aryanjaykadu/F1-sma-brake-duct/bench/Phase4_Bench_Dashboard.png

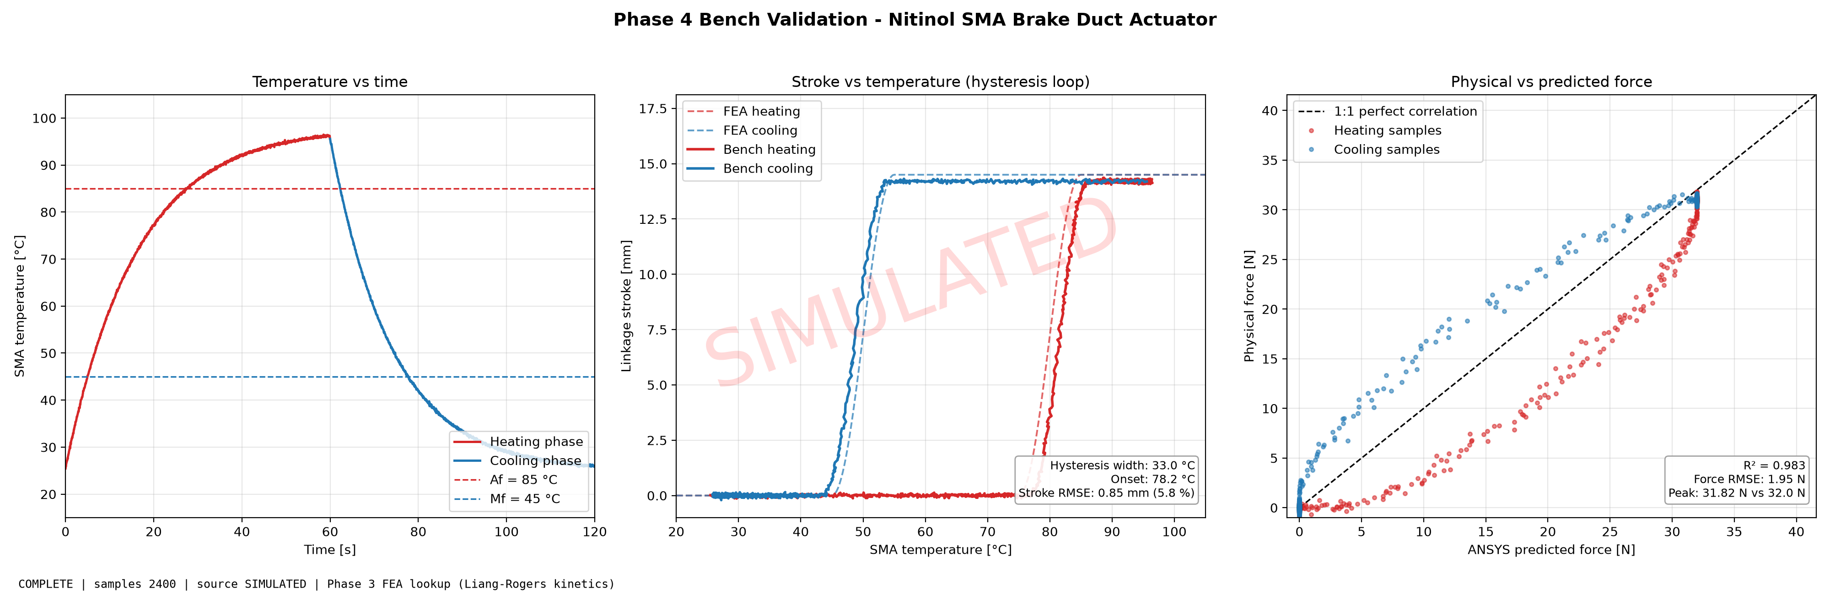
bench/Phase4_Bench_Dashboard.png
