aryanjaykadu/F1-sma-brake-duct/bench/virtual/Logger_Twin_Dashboard.png

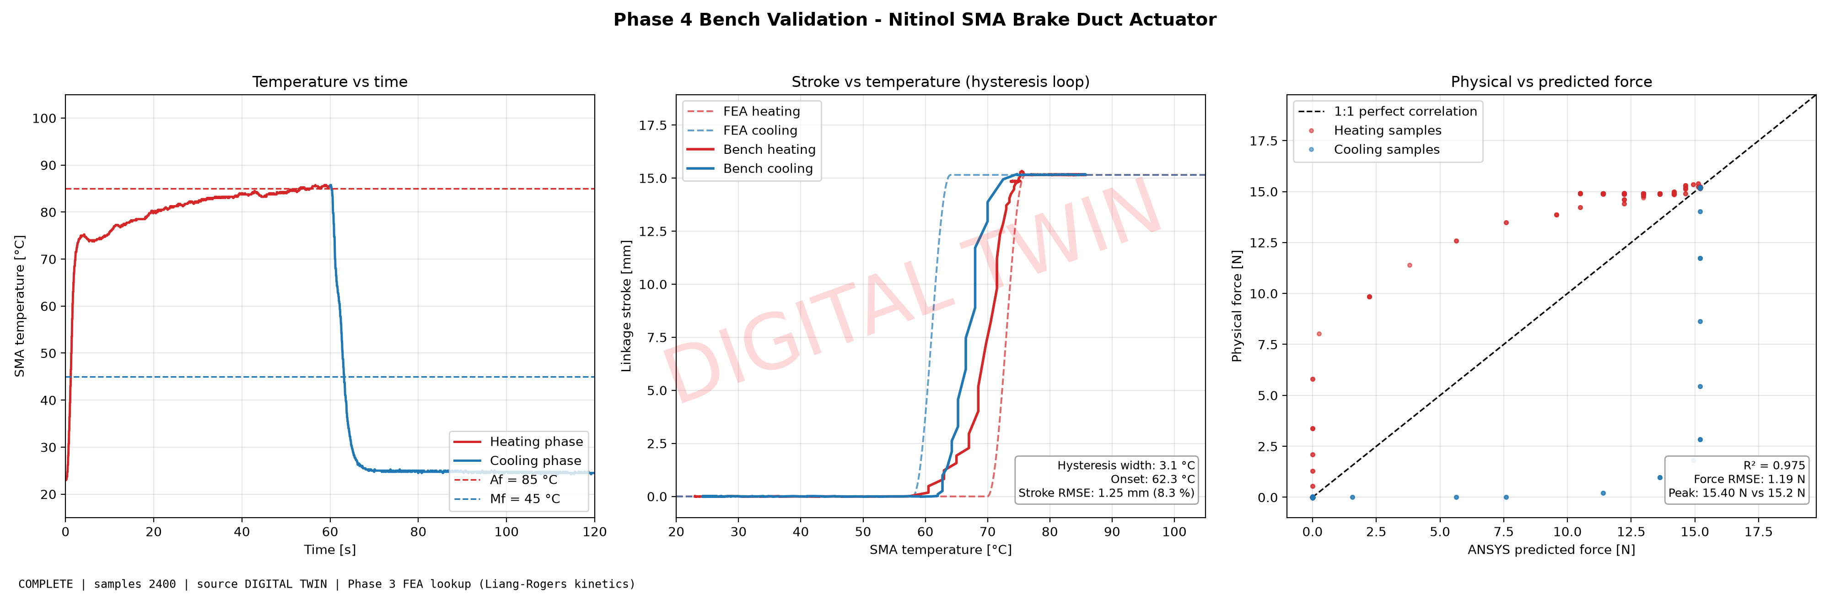
bench/virtual/Logger_Twin_Dashboard.png
