aryanjaykadu/F1-sma-brake-duct/bench/virtual/T4_endurance.png

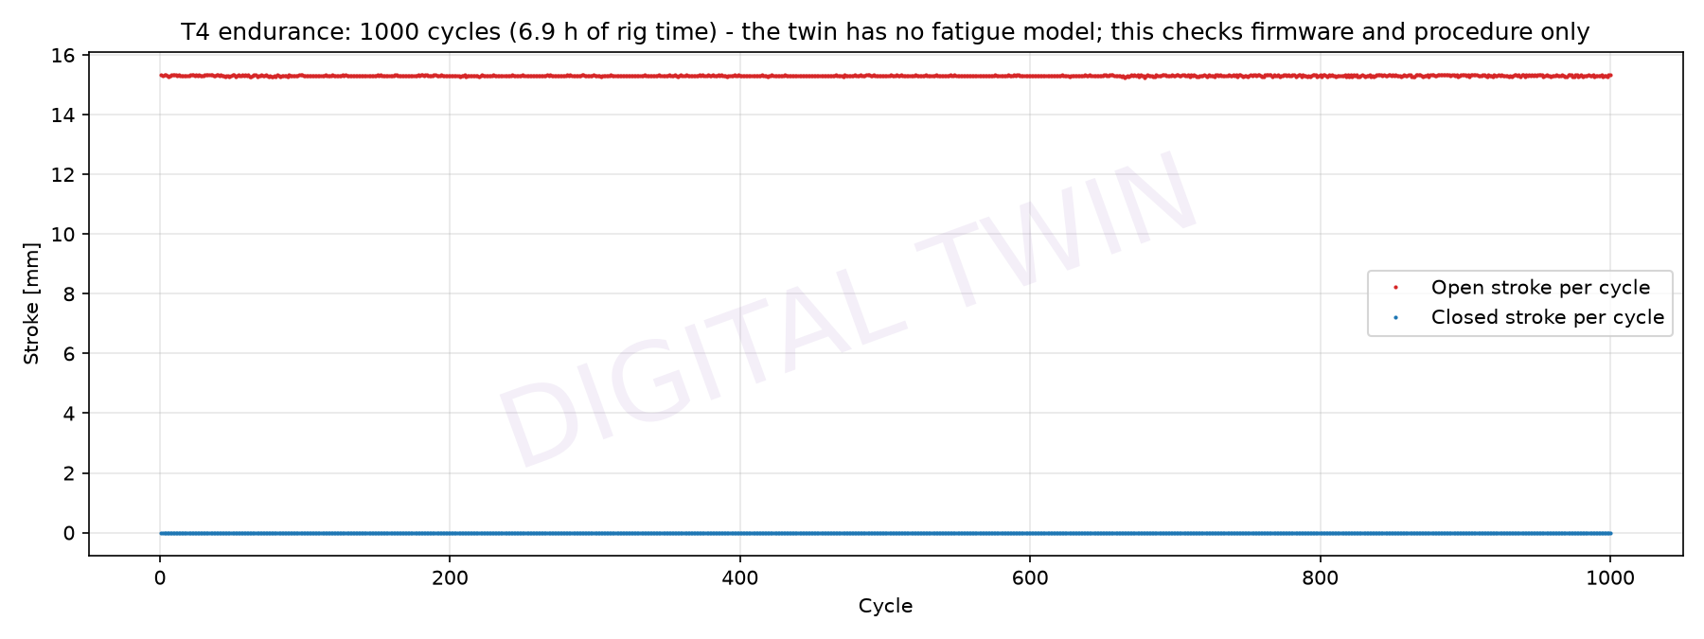
bench/virtual/T4_endurance.png
