aryanjaykadu/F1-sma-brake-duct/cad/Brake_Duct_Housing.png

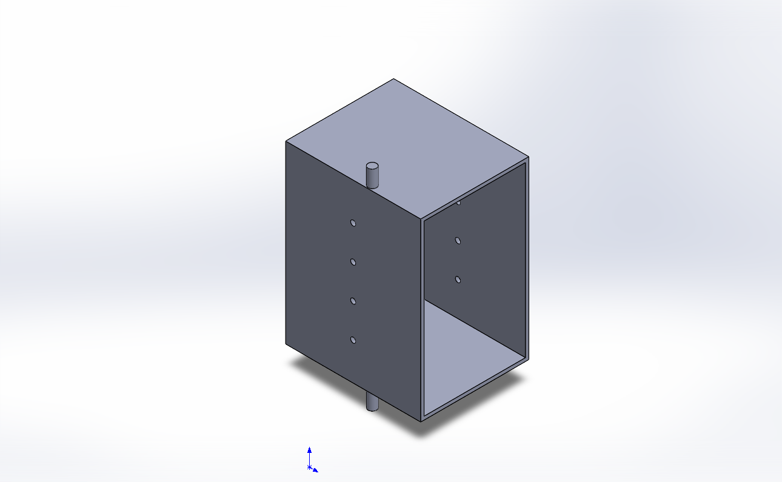
cad/Brake_Duct_Housing.png
