aryanjaykadu/F1-sma-brake-duct/cad/Control_Linkage_Rod.png

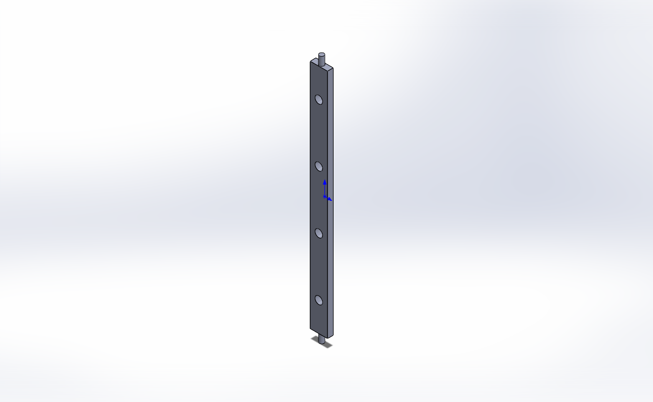
cad/Control_Linkage_Rod.png
