aryanjaykadu/F1-sma-brake-duct/cad/Nitinol_Louver_Flap.png

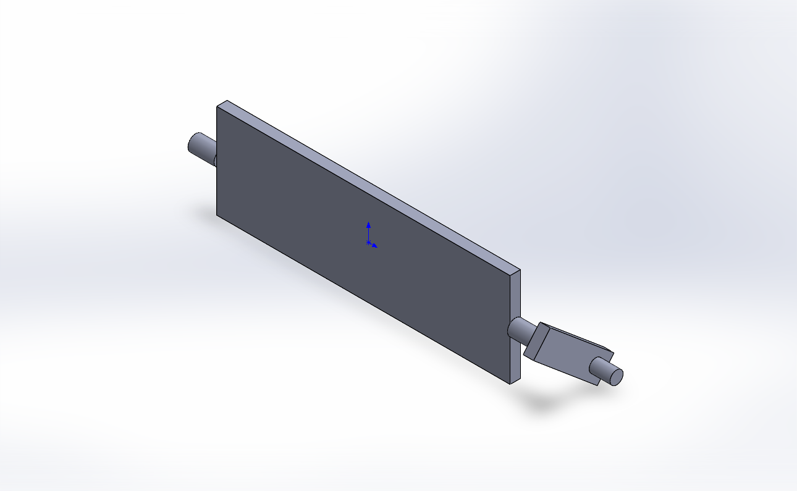
cad/Nitinol_Louver_Flap.png
