aryanjaykadu/F1-sma-brake-duct/cad/product/Module_right.png

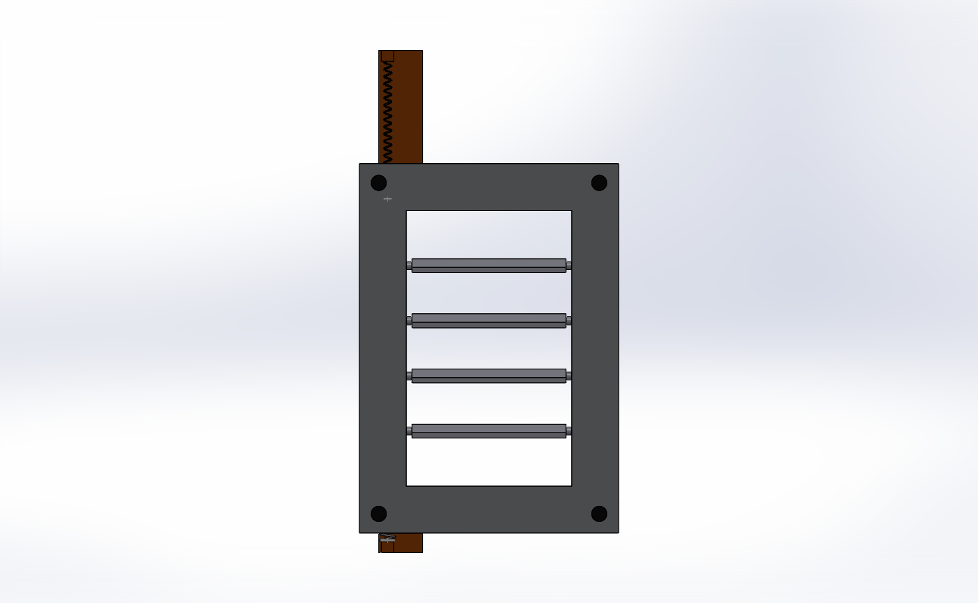
cad/product/Module_right.png
