aryanjaykadu/F1-sma-brake-duct/cad/rig/Bench_Rig_front.png

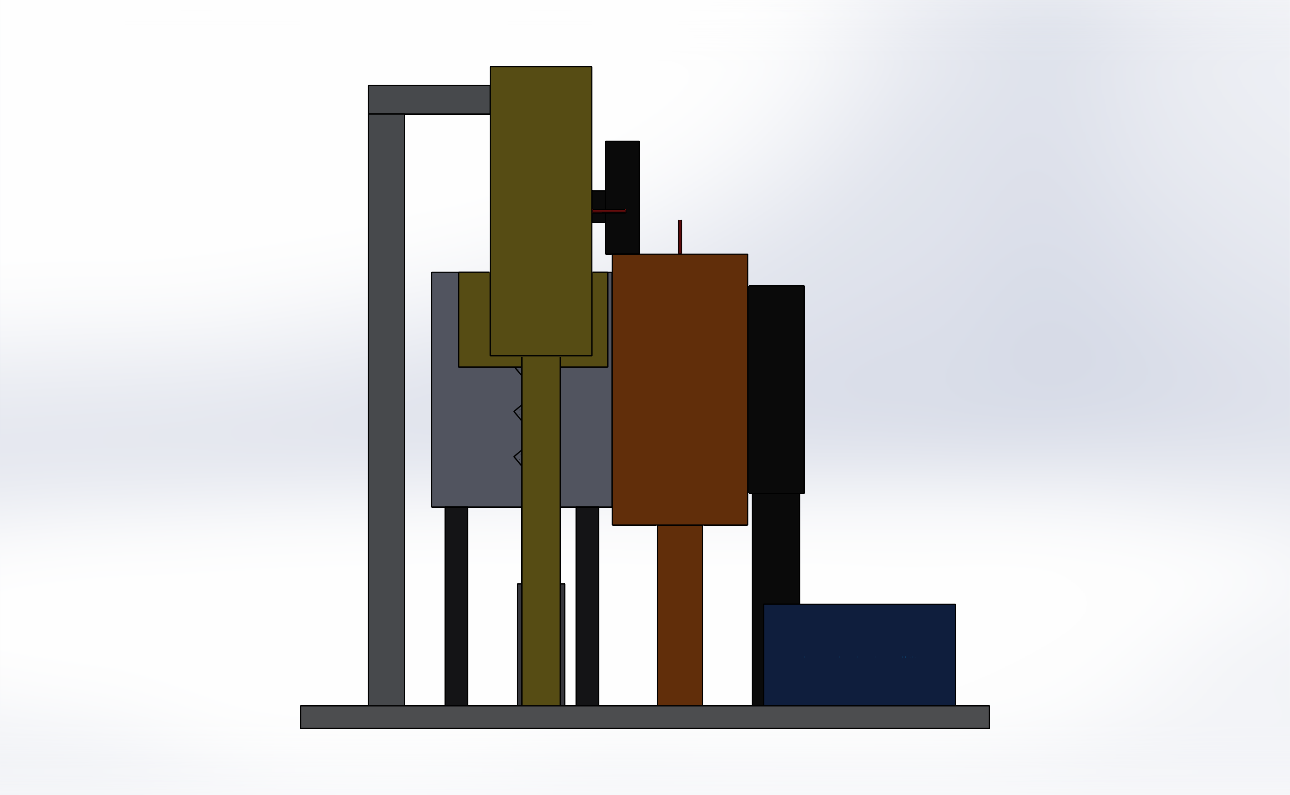
cad/rig/Bench_Rig_front.png
