aryanjaykadu/F1-sma-brake-duct/cad/rig/Bench_Rig_top.png

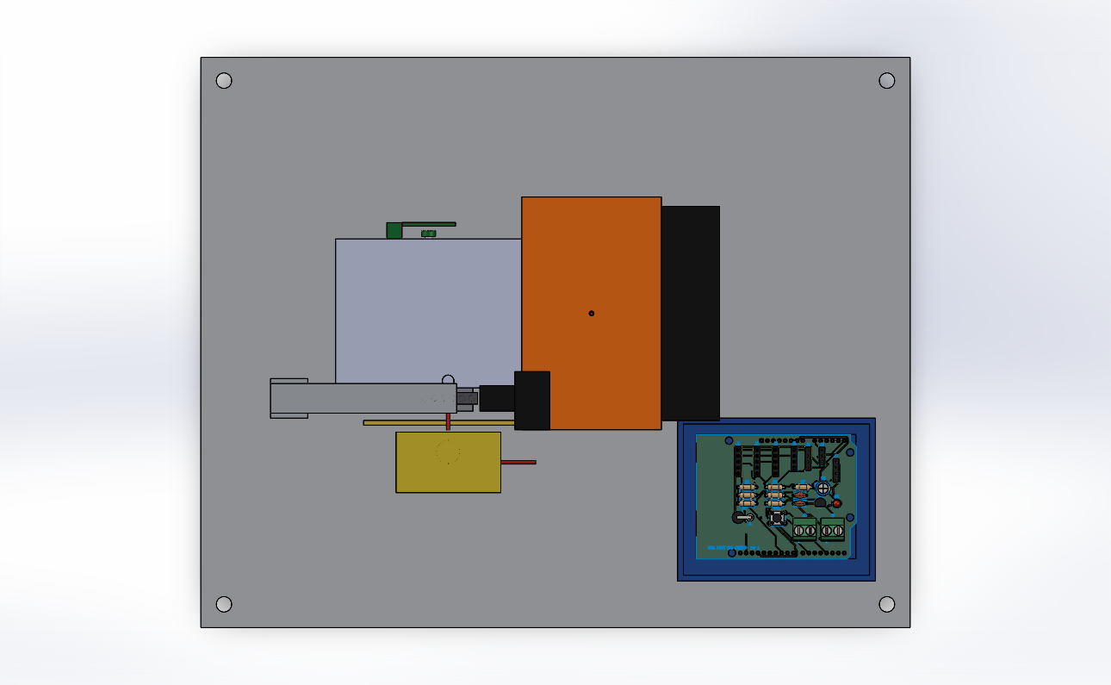
cad/rig/Bench_Rig_top.png
