aryanjaykadu/F1-sma-brake-duct/cad/rig/Sensor_Shield_PCB.png

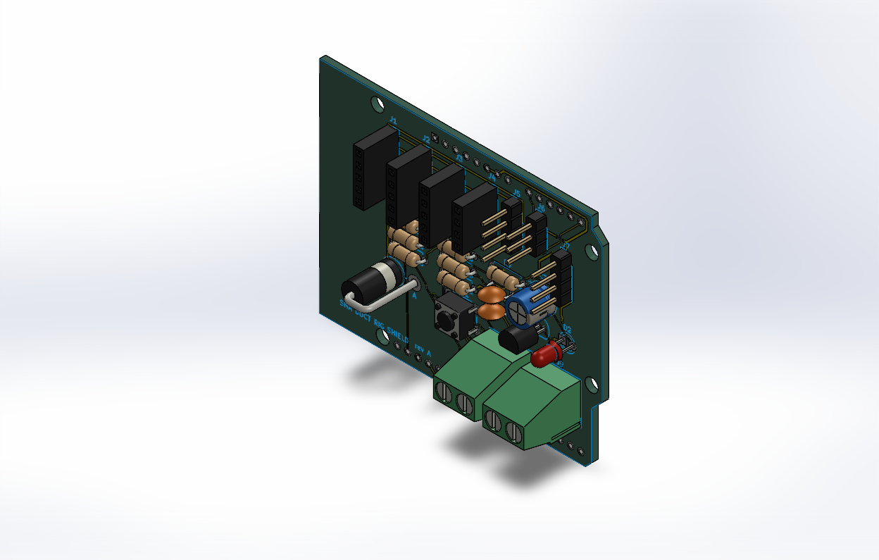
cad/rig/Sensor_Shield_PCB.png
