aryanjaykadu/F1-sma-brake-duct/cfd/Phase2_CHT_Domain.png

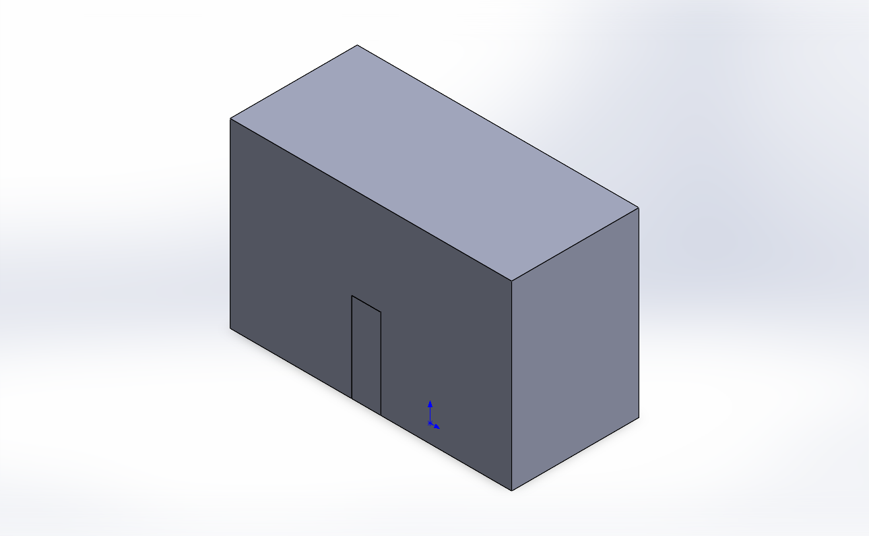
cfd/Phase2_CHT_Domain.png
