aryanjaykadu/F1-sma-brake-duct/cfd/SMA_Wire_Temperature_CaseB.png

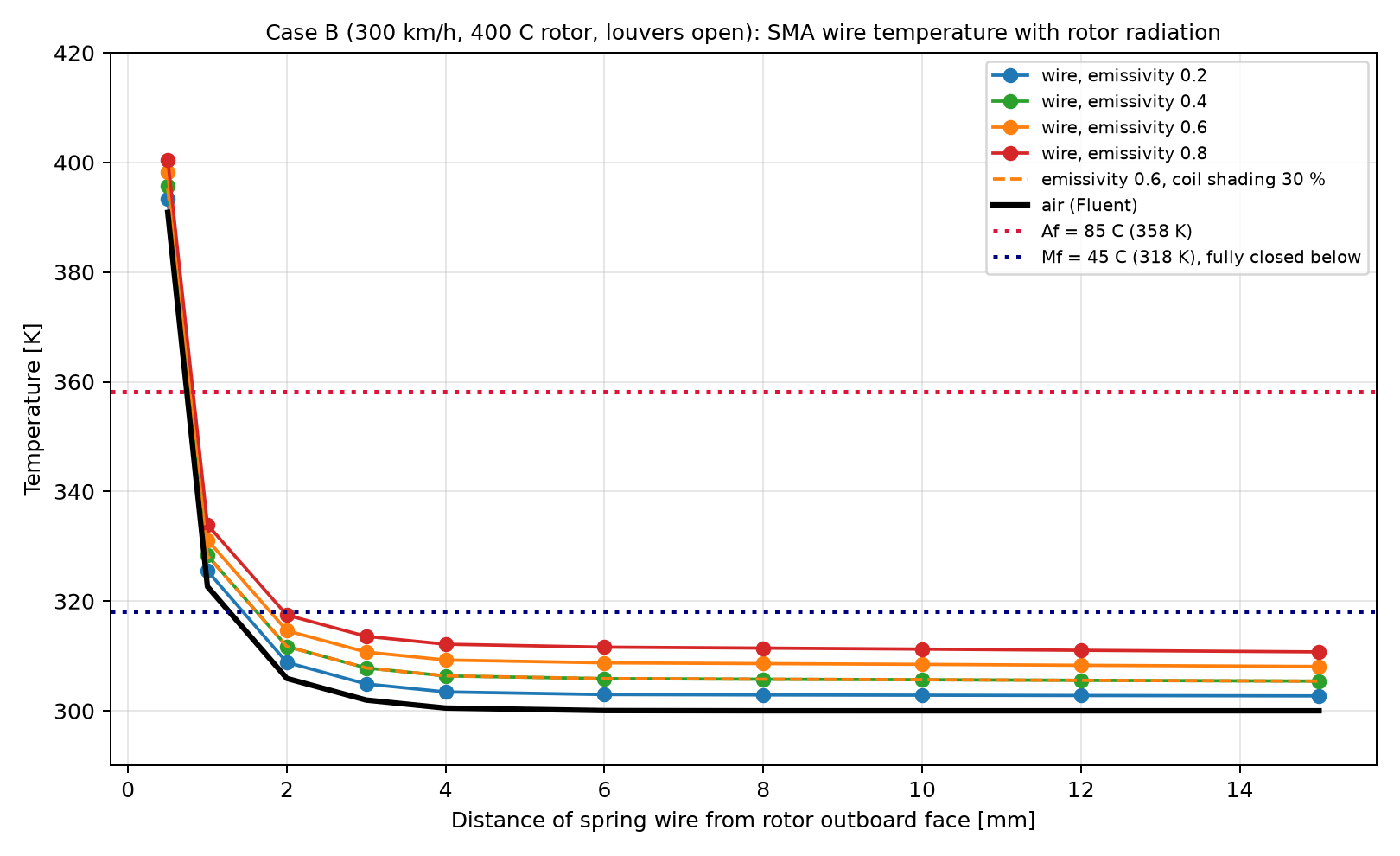
cfd/SMA_Wire_Temperature_CaseB.png
