aryanjaykadu/F1-sma-brake-duct/cfd/Temp_Contour_CaseA_baseline.png

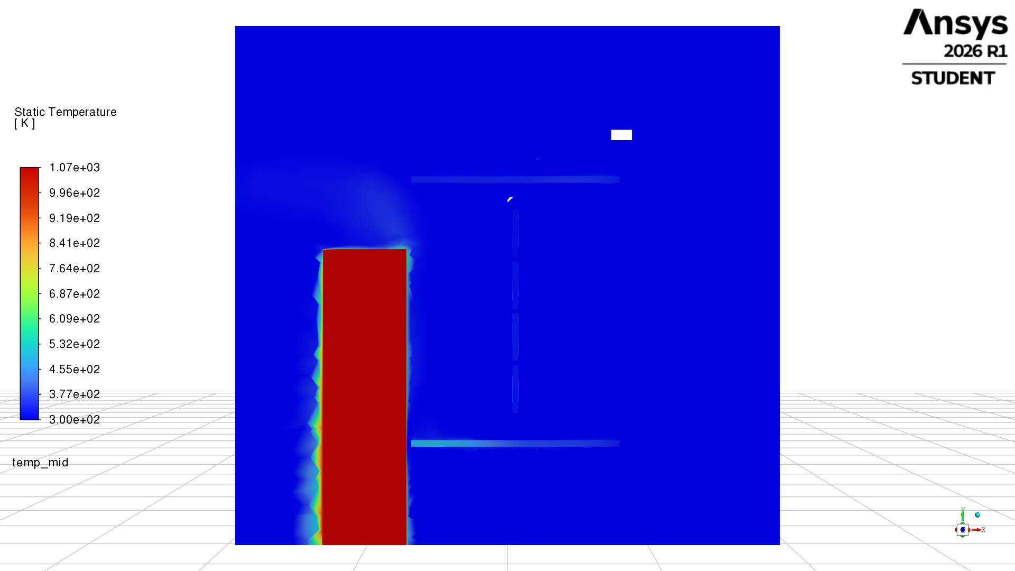
cfd/Temp_Contour_CaseA_baseline.png
