aryanjaykadu/F1-sma-brake-duct/cfd/transient/Transient_Lap_NiTi_Af85_gap6_eps0.6_d1.2.png

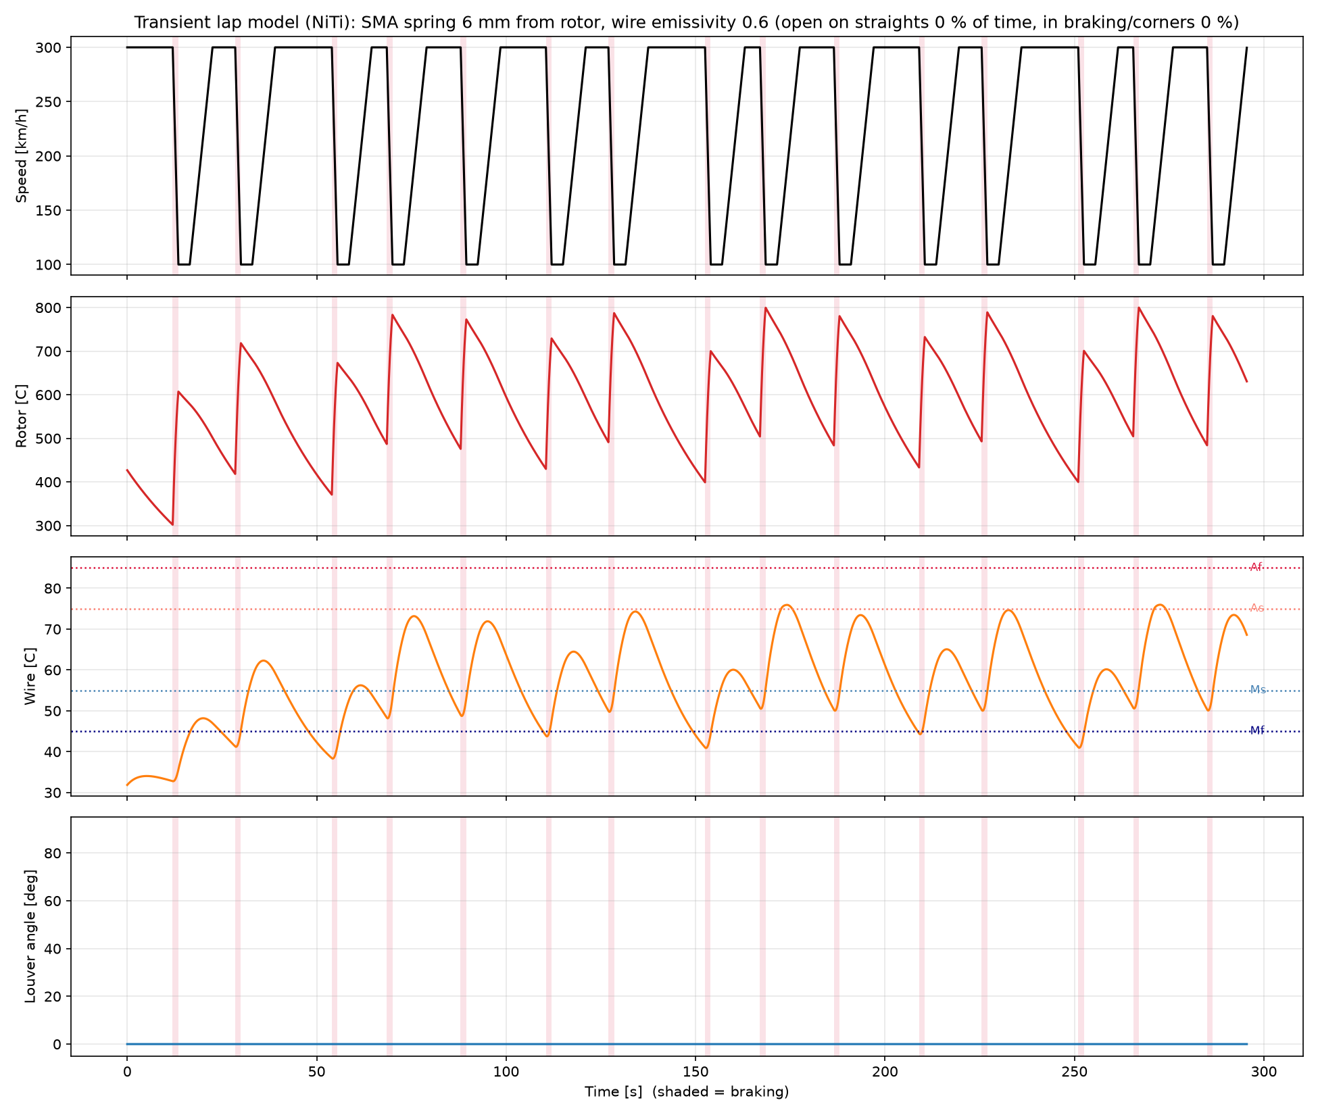
cfd/transient/Transient_Lap_NiTi_Af85_gap6_eps0.6_d1.2.png
