aryanjaykadu/F1-sma-brake-duct/cfd/Velocity_Contour_CaseA_baseline.png

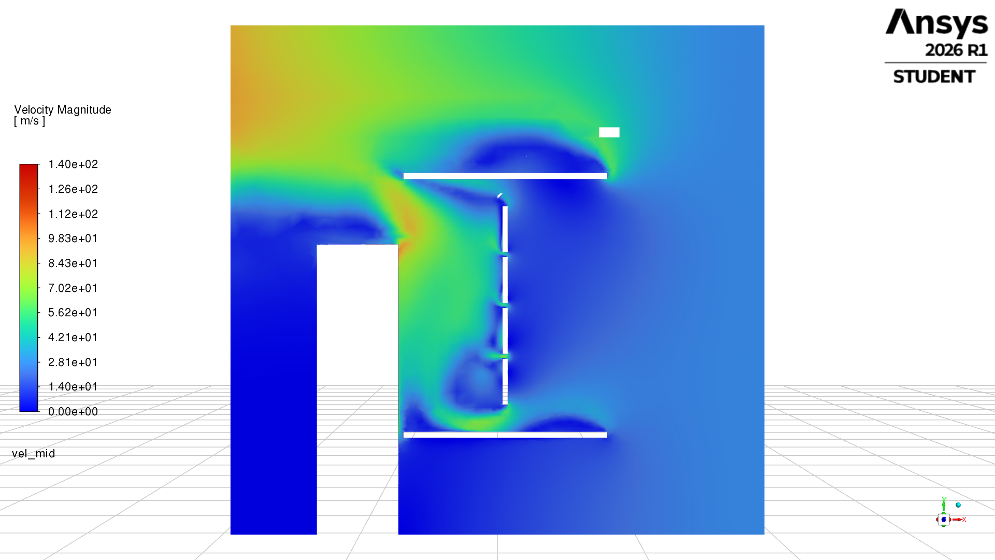
cfd/Velocity_Contour_CaseA_baseline.png
