aryanjaykadu/F1-sma-brake-duct/cfd/wheel/Wheel_Aero_Closed.png

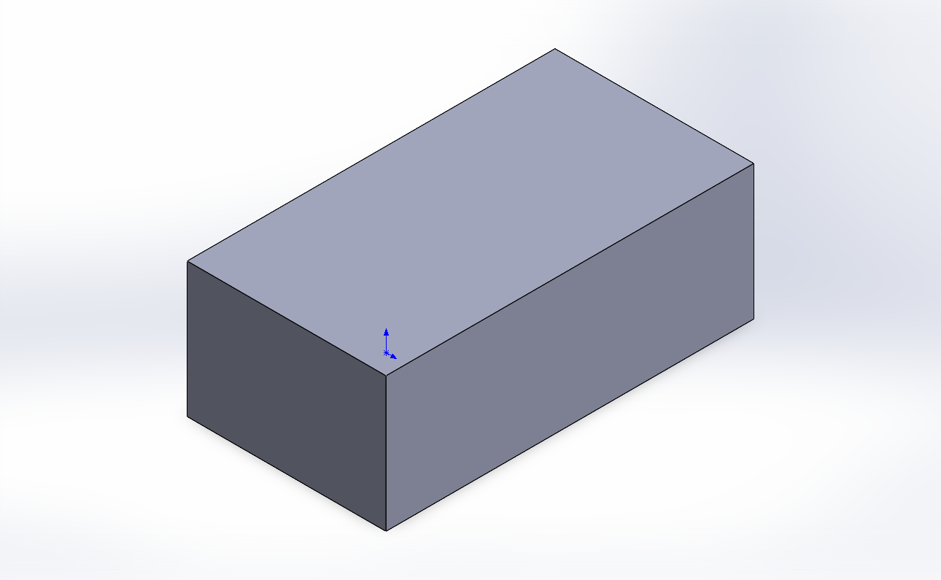
cfd/wheel/Wheel_Aero_Closed.png
