aryanjaykadu/F1-sma-brake-duct/electronics/kicad/render_bottom.png

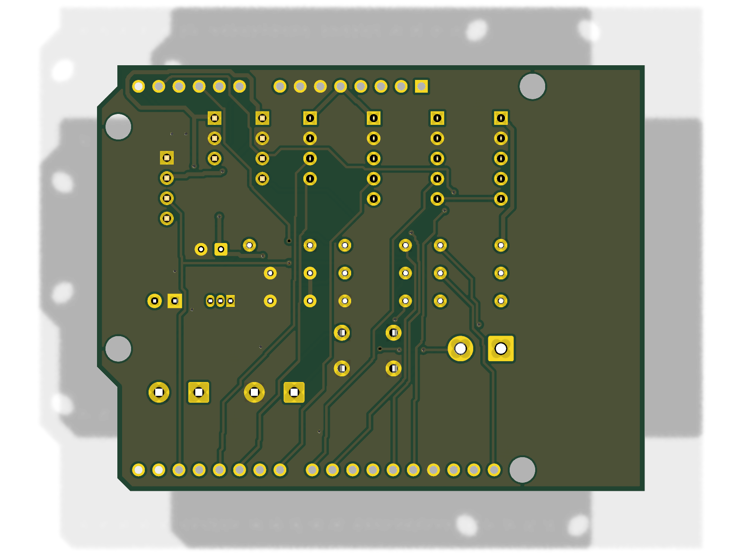
electronics/kicad/render_bottom.png
