aryanjaykadu/F1-sma-brake-duct/ev/cad/EV_Shutter_Closed_iso.png

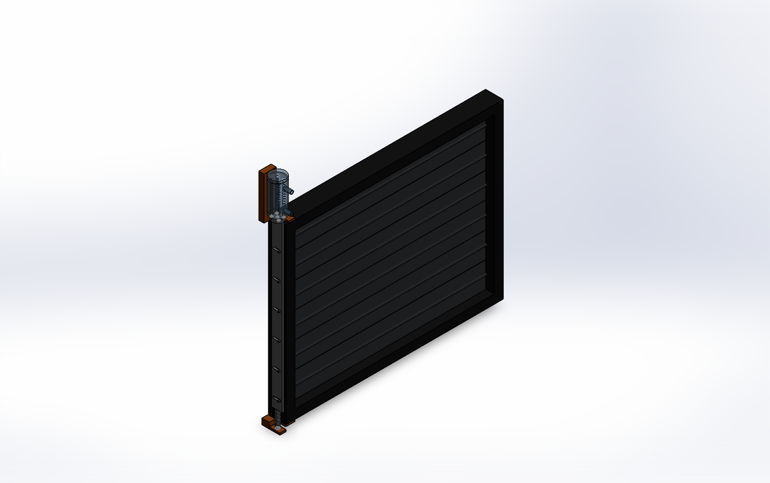
ev/cad/EV_Shutter_Closed_iso.png
