aryanjaykadu/F1-sma-brake-duct/ev/cad/EV_Shutter_Open_right.png

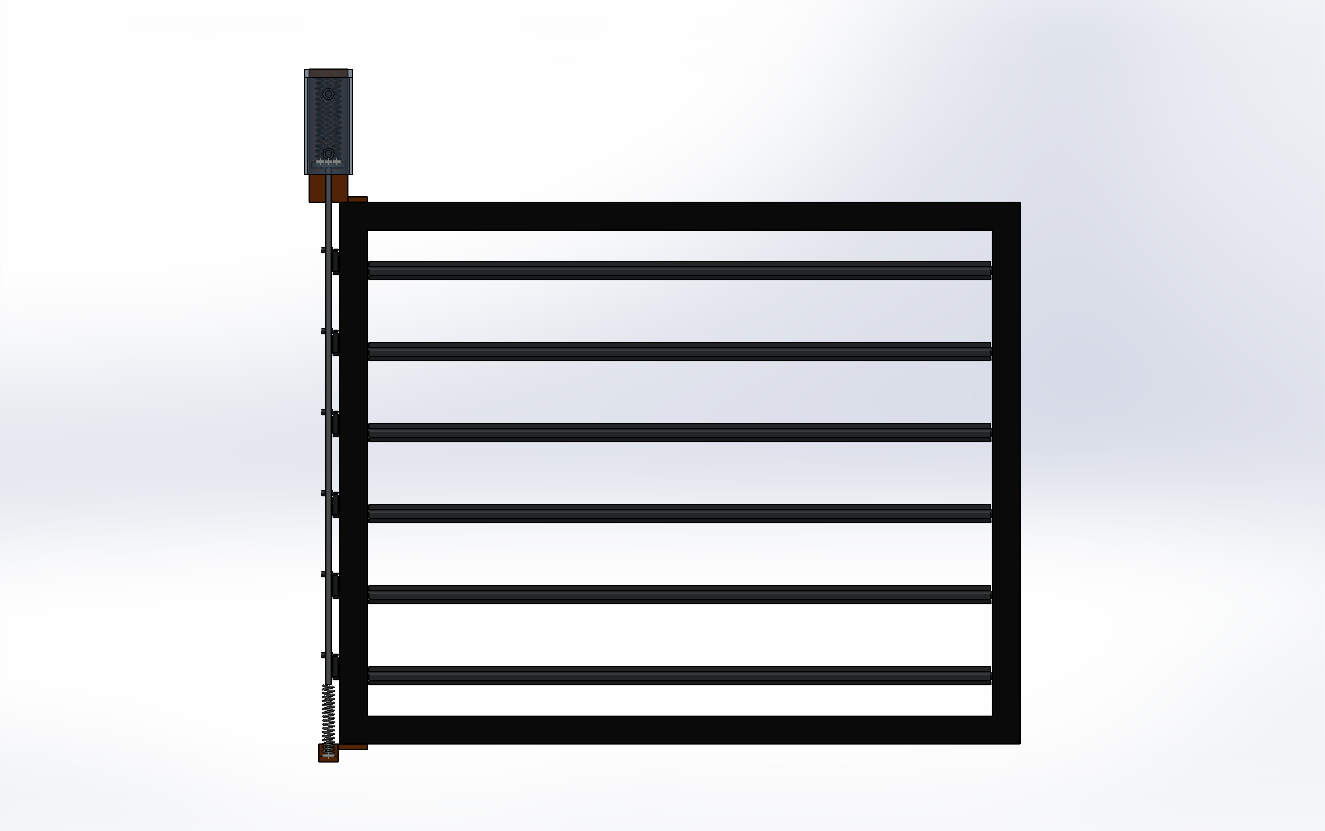
ev/cad/EV_Shutter_Open_right.png
