aryanjaykadu/F1-sma-brake-duct/ev/cfd/EV_Front_Closed.png

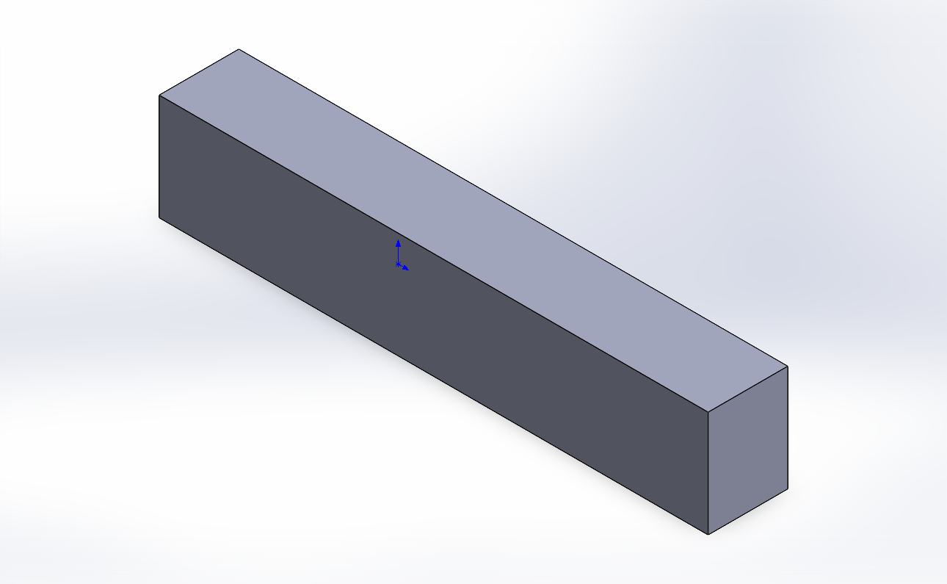
ev/cfd/EV_Front_Closed.png
