aryanjaykadu/F1-sma-brake-duct/ev/EV_System_city_wltc_x2_25C.png

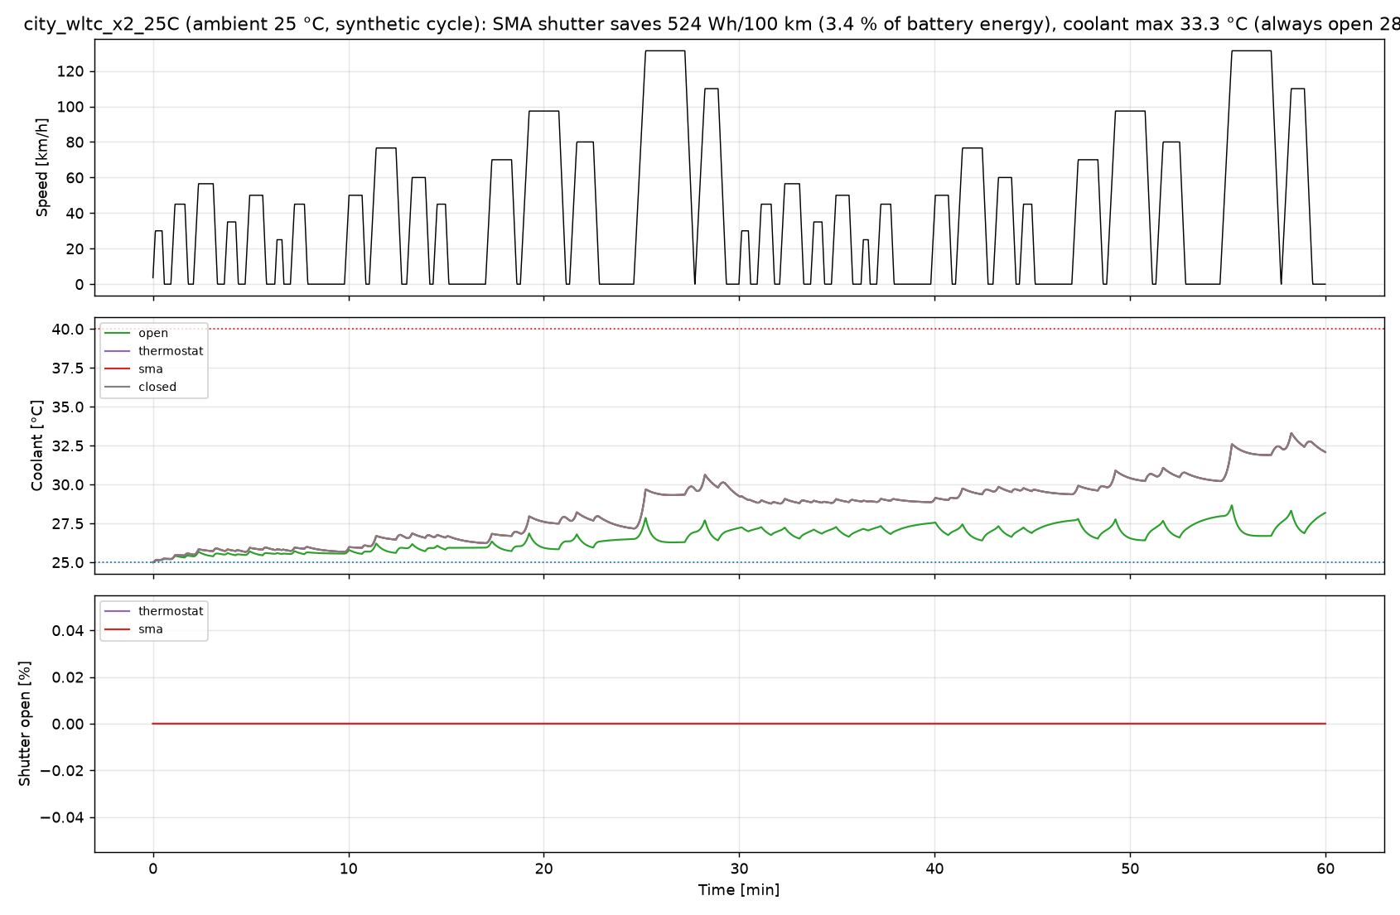
ev/EV_System_city_wltc_x2_25C.png
