aryanjaykadu/F1-sma-brake-duct/ev/EV_System_hot_day_motorway_38C.png

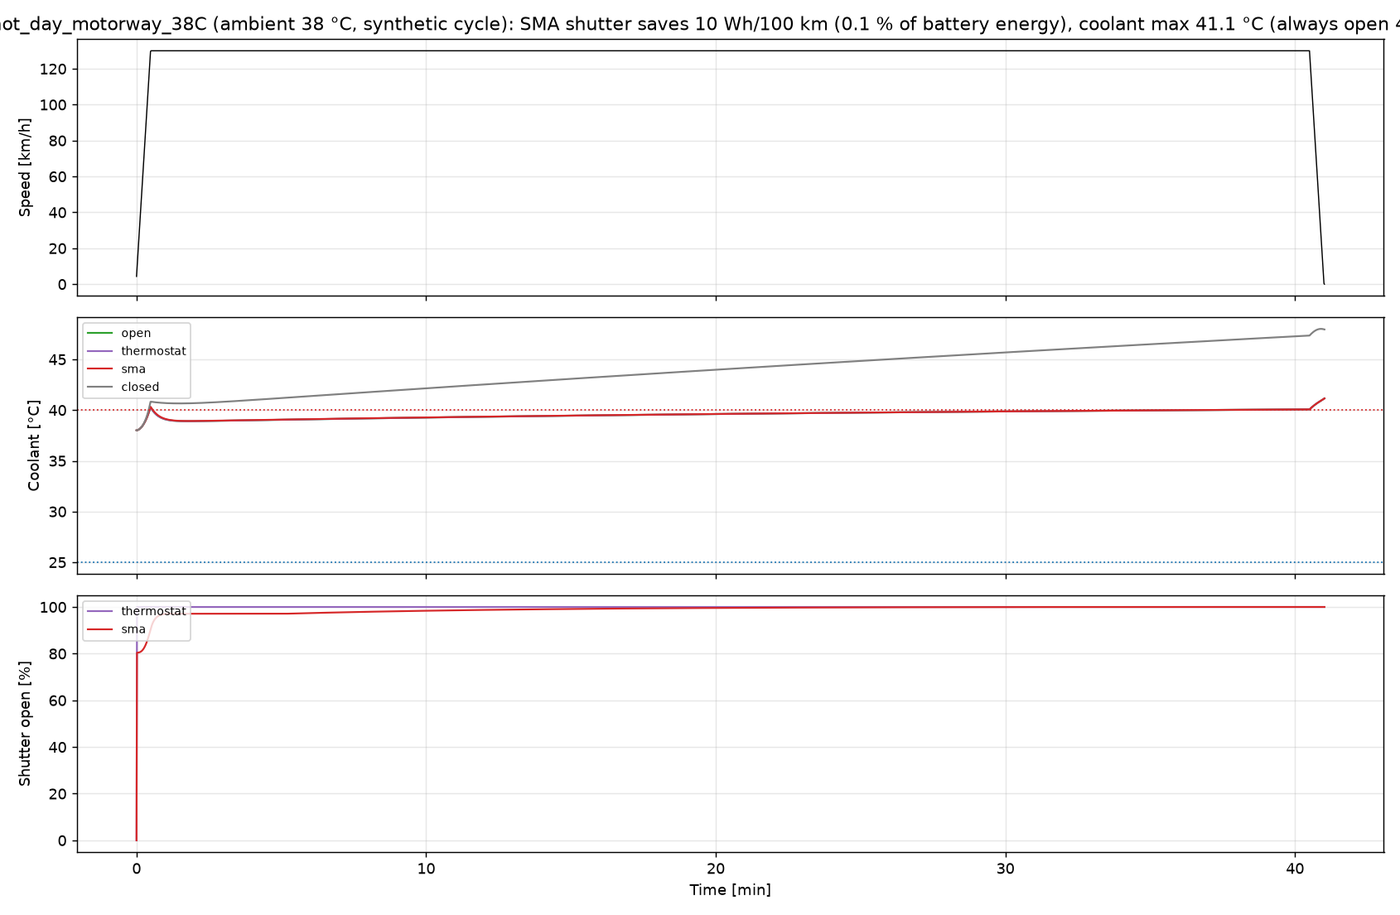
ev/EV_System_hot_day_motorway_38C.png
