aryanjaykadu/F1-sma-brake-duct/ev/EV_System_hot_day_motorway_38C_kappa_cfd.png

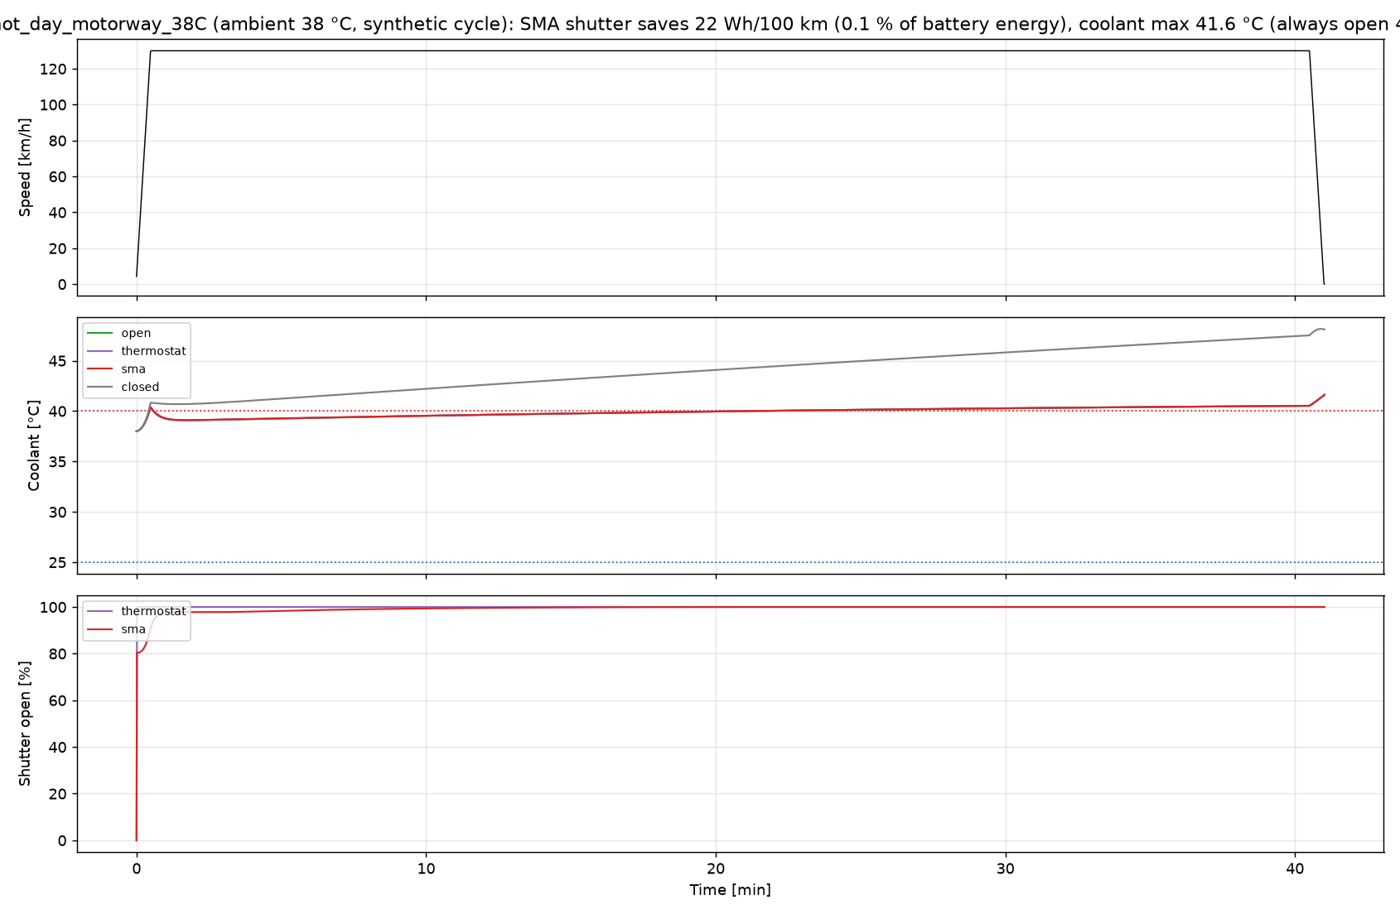
ev/EV_System_hot_day_motorway_38C_kappa_cfd.png
