aryanjaykadu/F1-sma-brake-duct/ev/EV_System_motorway_130_30C_kappa_cfd.png

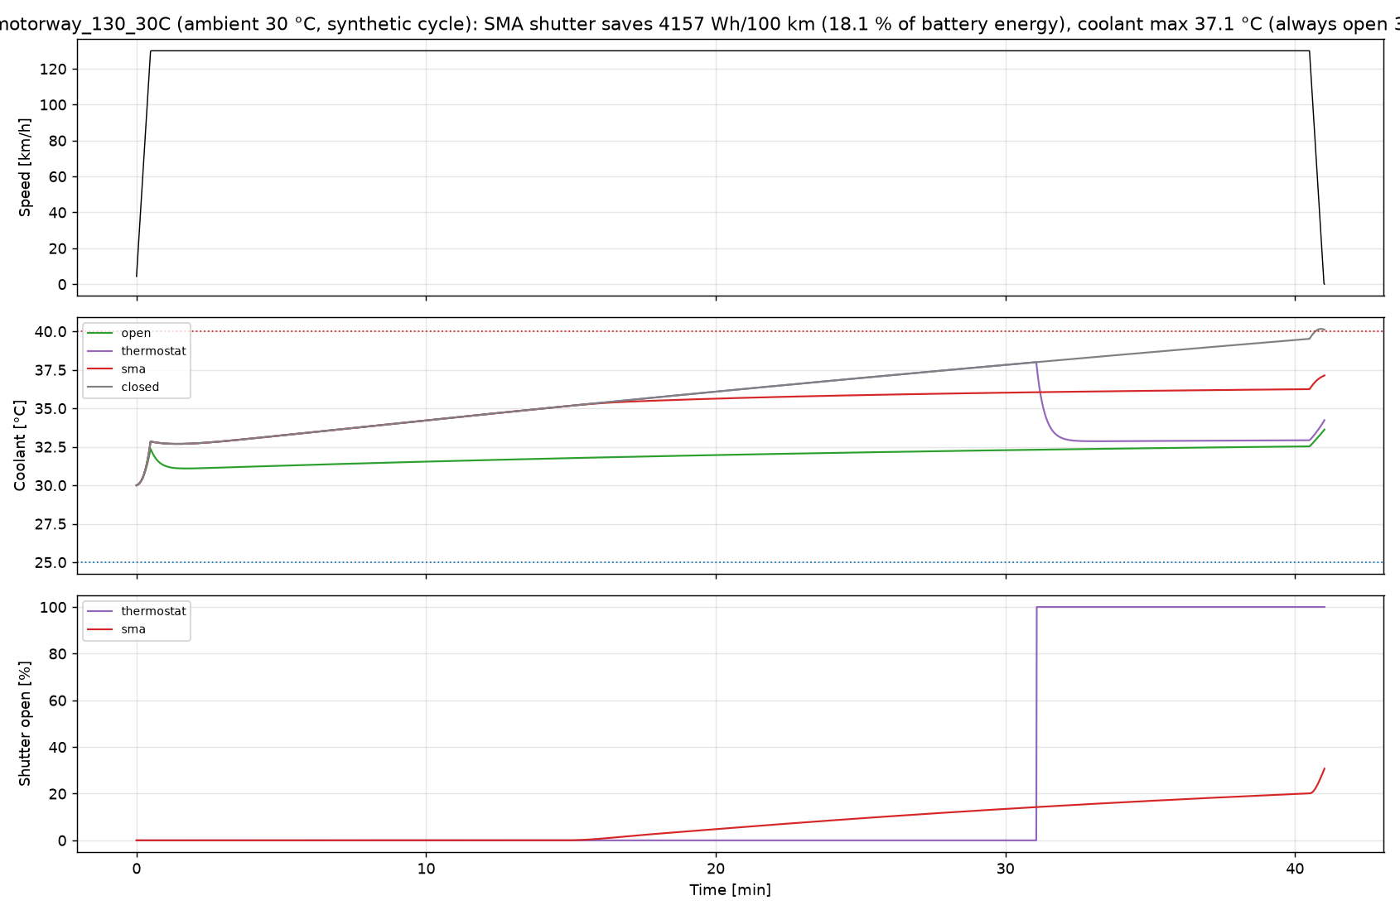
ev/EV_System_motorway_130_30C_kappa_cfd.png
