aryanjaykadu/F1-sma-brake-duct/fea/FEA_Deformation_Map.png

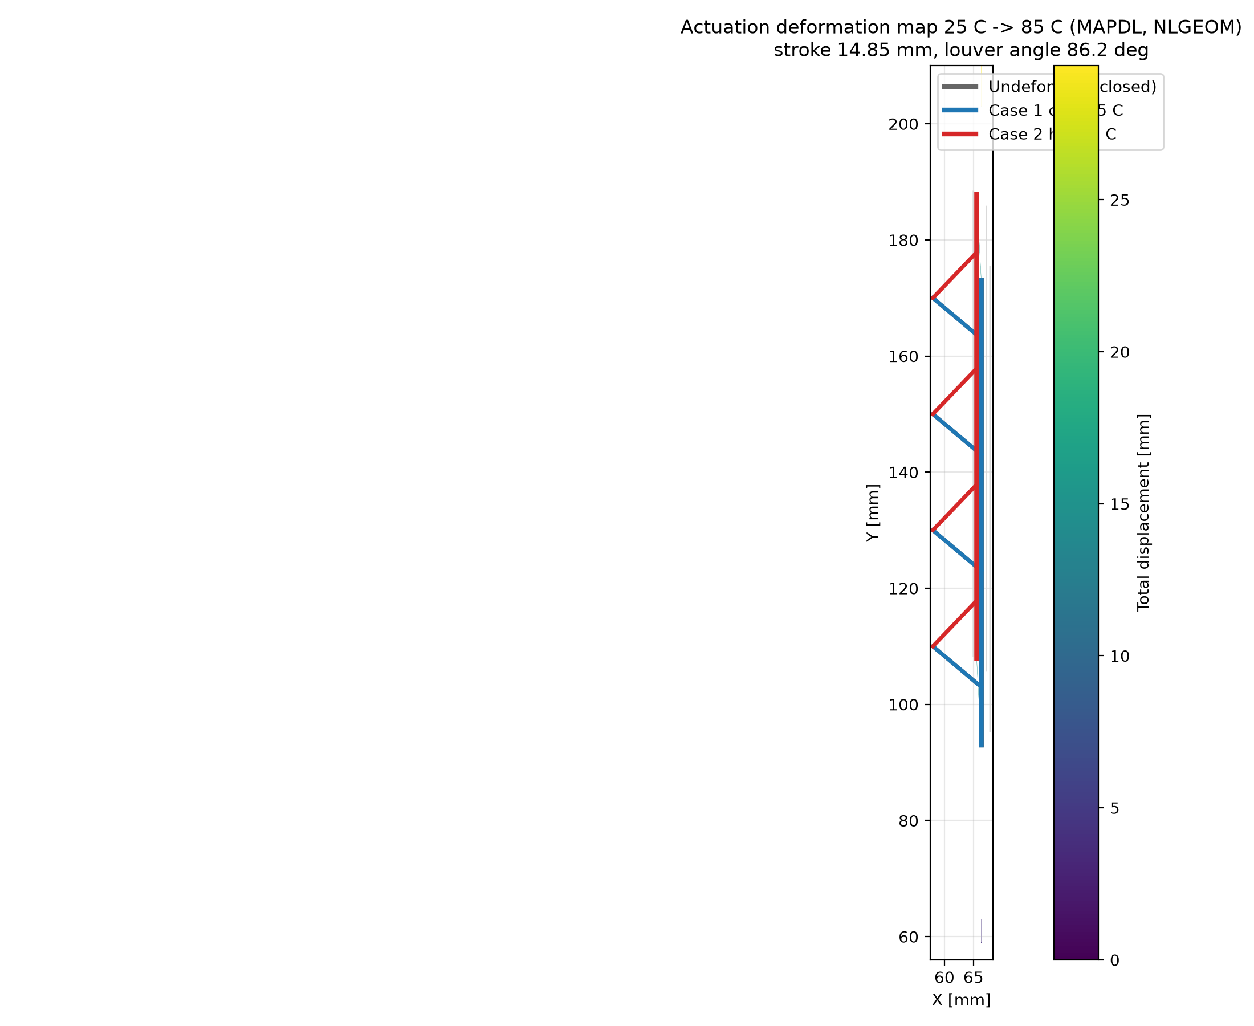
fea/FEA_Deformation_Map.png
