aryanjaykadu/F1-sma-brake-duct/fea/FEA_Stress_Contour_Hot.png

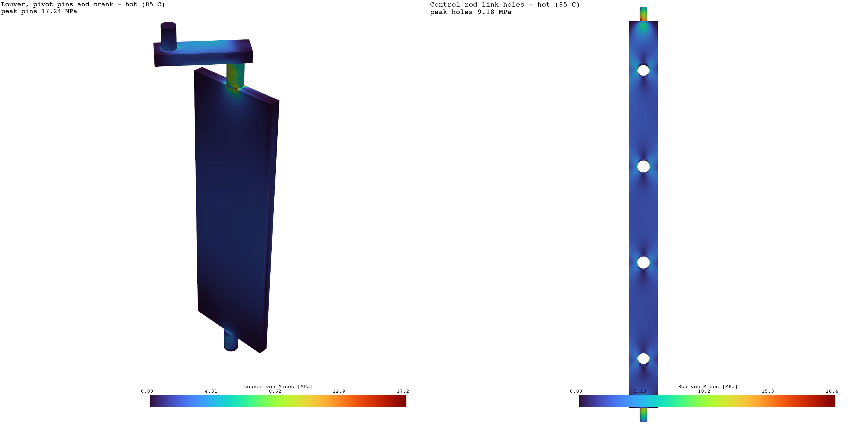
fea/FEA_Stress_Contour_Hot.png
