aryanjaykadu/F1-sma-brake-duct/fea/pack_NiTiCu/Nitinol_Force_Displacement_Plot.png

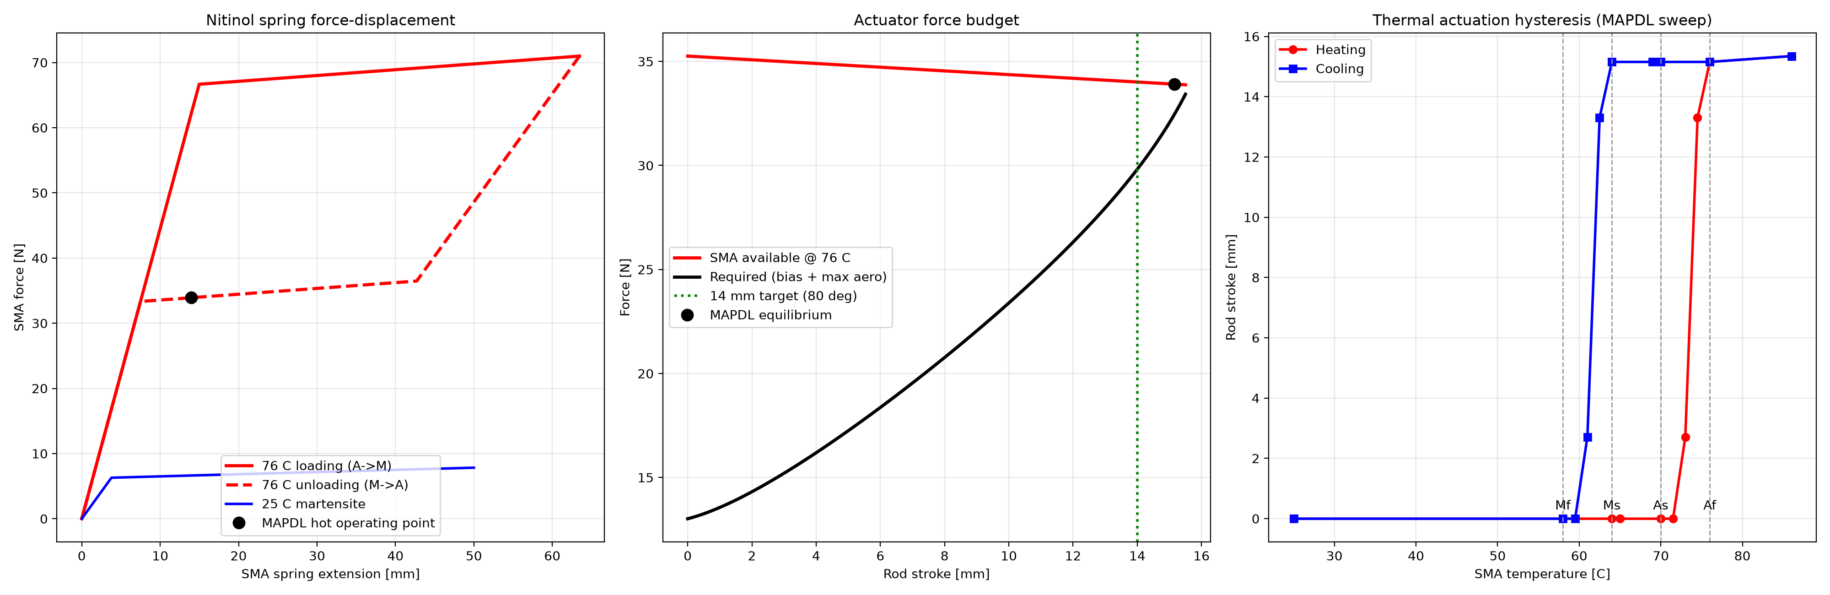
fea/pack_NiTiCu/Nitinol_Force_Displacement_Plot.png
