aryanjaykadu/F1-sma-brake-duct/report/assets/fig_packaging.png

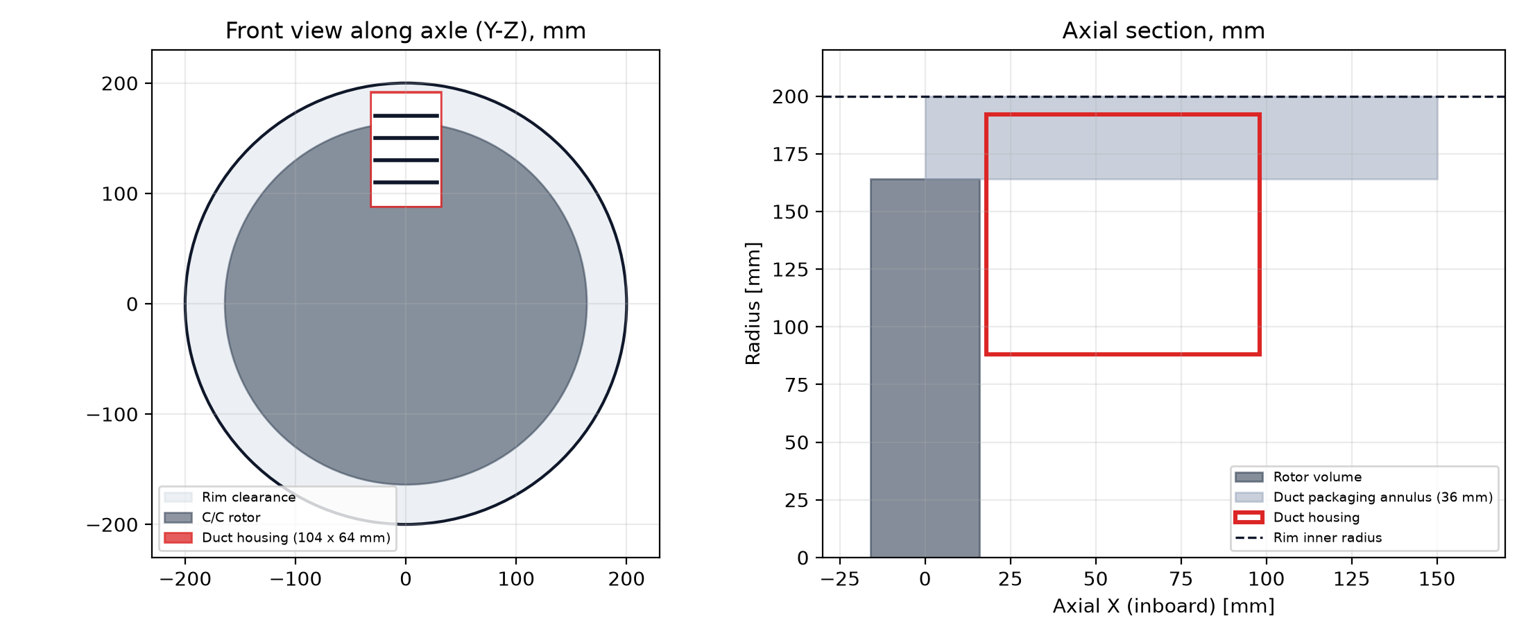
report/assets/fig_packaging.png
