aryanjaykadu/F1-sma-brake-duct/electronics/kicad/fab/sma_rig_shield_bom.csv

Refs | Value | Footprint | Qty | DNP
A1 | Arduino_UNO_R3 | Module:Arduino_UNO_R3_WithMountingHoles | 1
C1 | 100n | Capacitor_THT:C_Disc_D5.0mm_W2.5mm_P5.00mm | 1
C2 | 100n | Capacitor_THT:C_Disc_D5.0mm_W2.5mm_P5.00mm | 1
C3 | 47u | Capacitor_THT:CP_Radial_D6.3mm_P2.50mm | 1
D1 | 1N5822 | Diode_THT:D_DO-201AD_P5.08mm_Vertical_AnodeUp | 1
D2 | LED | LED_THT:LED_D3.0mm | 1
J1 | TC1 MAX31855 (spring) | Connector_PinSocket_2.54mm:PinSocket_1x05_P2.54mm_Vertical | 1
J2 | TC2 MAX31855 (air) | Connector_PinSocket_2.54mm:PinSocket_1x05_P2.54mm_Vertical | 1
J3 | TC3 MAX31855 (heater) | Connector_PinSocket_2.54mm:PinSocket_1x05_P2.54mm_Vertical | 1
J4 | HX711 load cell | Connector_PinSocket_2.54mm:PinSocket_1x04_P2.54mm_Vertical | 1
J5 | AS5600 angle | Connector_PinHeader_2.54mm:PinHeader_1x04_P2.54mm_Vertical | 1
J6 | MPXV7002 pitot | Connector_PinHeader_2.54mm:PinHeader_1x03_P2.54mm_Vertical | 1
J7 | Fan 4-pin | Connector_PinHeader_2.54mm:PinHeader_1x04_P2.54mm_Vertical | 1
J8 | 12V in | TerminalBlock_Phoenix:TerminalBlock_Phoenix_MKDS-1,5-2_1x02_P5.00mm_Horizontal | 1
J9 | Heater SSR input | TerminalBlock_Phoenix:TerminalBlock_Phoenix_MKDS-1,5-2_1x02_P5.00mm_Horizontal | 1
Q1 | 2N7000 | Package_TO_SOT_THT:TO-92_Inline | 1
R1 | 4k7 | Resistor_THT:R_Axial_DIN0207_L6.3mm_D2.5mm_P7.62mm_Horizontal | 1
R2 | 4k7 | Resistor_THT:R_Axial_DIN0207_L6.3mm_D2.5mm_P7.62mm_Horizontal | 1
R3 | 10k | Resistor_THT:R_Axial_DIN0207_L6.3mm_D2.5mm_P7.62mm_Horizontal | 1
R4 | 1k | Resistor_THT:R_Axial_DIN0207_L6.3mm_D2.5mm_P7.62mm_Horizontal | 1
R5 | 100 | Resistor_THT:R_Axial_DIN0207_L6.3mm_D2.5mm_P7.62mm_Horizontal | 1
R6 | 100k | Resistor_THT:R_Axial_DIN0207_L6.3mm_D2.5mm_P7.62mm_Horizontal | 1
R7 | 1k | Resistor_THT:R_Axial_DIN0207_L6.3mm_D2.5mm_P7.62mm_Horizontal | 1
SW1 | START | Button_Switch_THT:SW_PUSH_6mm | 1
