aryanjaykadu/F1-sma-brake-duct/cfd/Phase2_CHT_Domain_baseline.SLDPRT

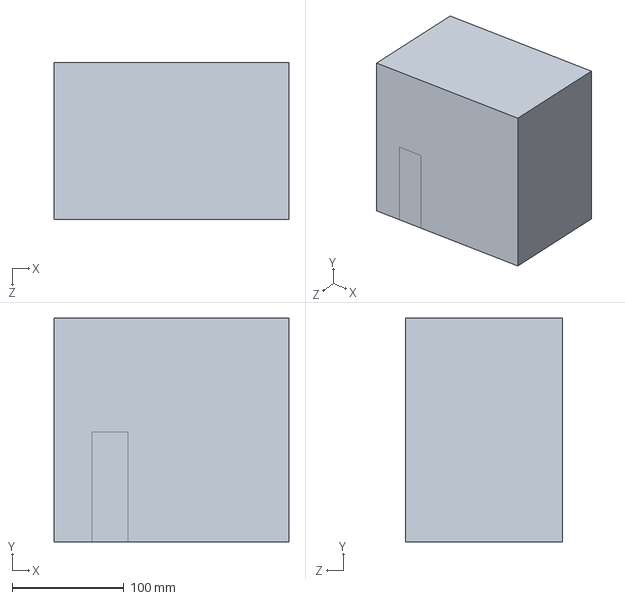
[picture p55: CAD file, 2026-11-11]
cfd/Phase2_CHT_Domain_baseline.SLDPRT
210.0 x 200.0 x 140.0 mm
