aryanjaykadu/F1-sma-brake-duct/cfd/Phase2_CHT_Domain_CaseB.SLDPRT

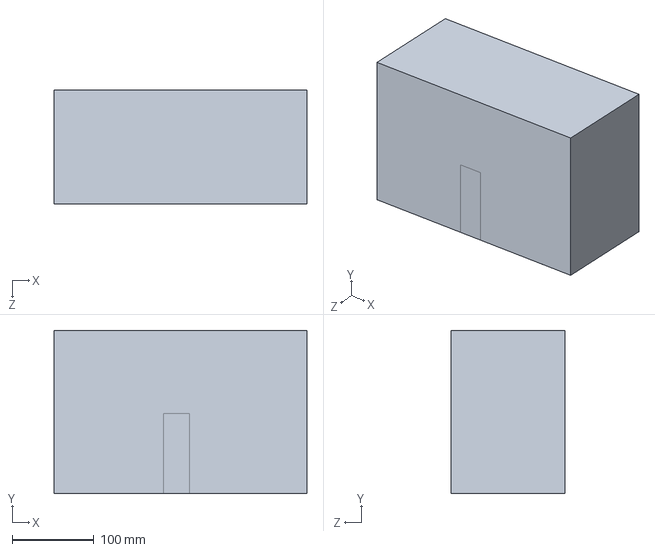
[picture p56: CAD file, 2026-11-11]
cfd/Phase2_CHT_Domain_CaseB.SLDPRT
310.0 x 200.0 x 140.0 mm
