aryanjaykadu/F1-sma-brake-duct/cad/product/Spring_Bracket_Top.SLDPRT

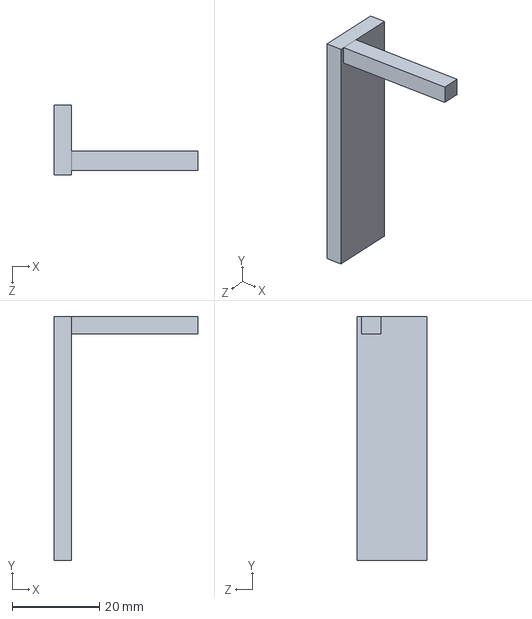
[picture p57: CAD file, 2026-11-13]
cad/product/Spring_Bracket_Top.SLDPRT
33.0 x 56.0 x 16.0 mm
