aryanjaykadu/F1-sma-brake-duct/cad/rig/Rig_Base_Plate.STEP

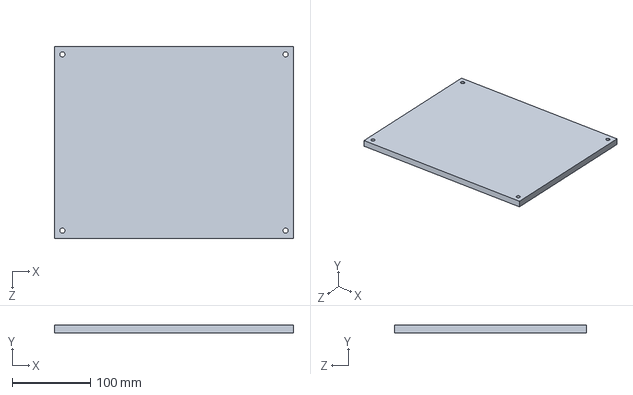
[picture p58: CAD file, 2026-11-13]
cad/rig/Rig_Base_Plate.STEP
305.0 x 10.0 x 245.0 mm
