aryanjaykadu/F1-sma-brake-duct/cfd/wheel/Wheel_Aero_Closed.SLDPRT

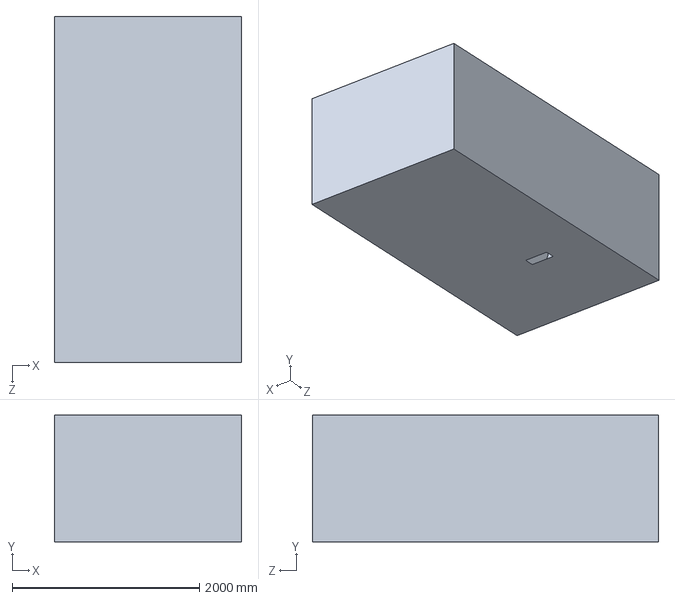
[picture p59: CAD file, 2026-11-11]
cfd/wheel/Wheel_Aero_Closed.SLDPRT
2000.0 x 1355.0 x 3700.0 mm
