aryanjaykadu/F1-sma-brake-duct/electronics/kicad/sma_rig_shield.step

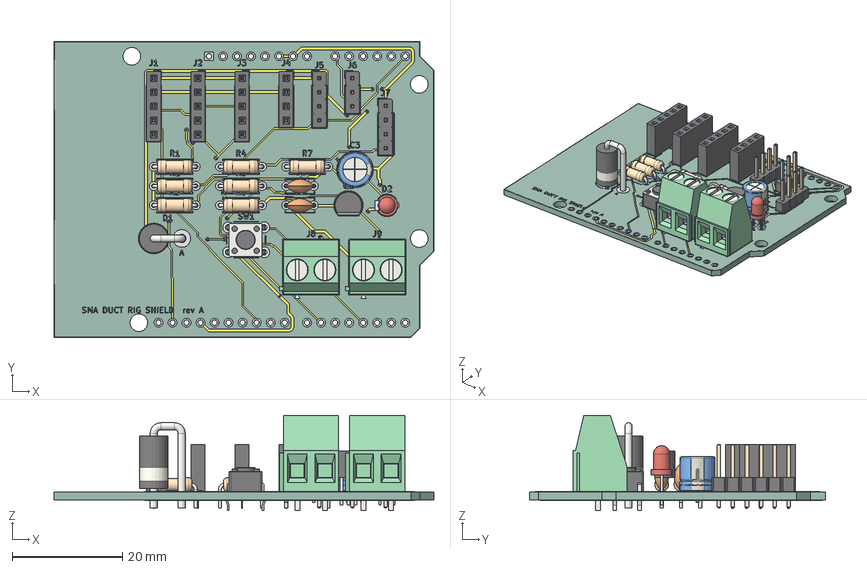
[picture p60: CAD file, 2026-11-13]
electronics/kicad/sma_rig_shield.step
68.8 x 53.6 x 17.3 mm
LED_D3.0mm
PinSocket_1x05_P2.54mm_Vertical x 3
R_Axial_DIN0207_L63mm_D25mm_P762mm_Horizontal x 7
C_Disc_D50mm_W25mm_P500mm x 2
CP_Radial_D63mm_P250mm
PinHeader_1x04_P254mm_Vertical x 2
PinHeader_1x03_P254mm_Vertical
TerminalBlock_Phoenix_MKDS-1,5-2_1x02_P5.00mm_Horizontal x 2
D_DO-201AD_P5.08mm_Vertical_AnodeUp
TO-92_Inline_Narrow
SW_PUSH_6mm
PinSocket_1x04_P2.54mm_Vertical
sma_rig_shield_copper
sma_rig_shield_pad
sma_rig_shield_via
sma_rig_shield_silkscreen
sma_rig_shield_PCB
