aryanjaykadu/F1-sma-brake-duct/ev/cad/EV_Actuator_Bracket.SLDPRT

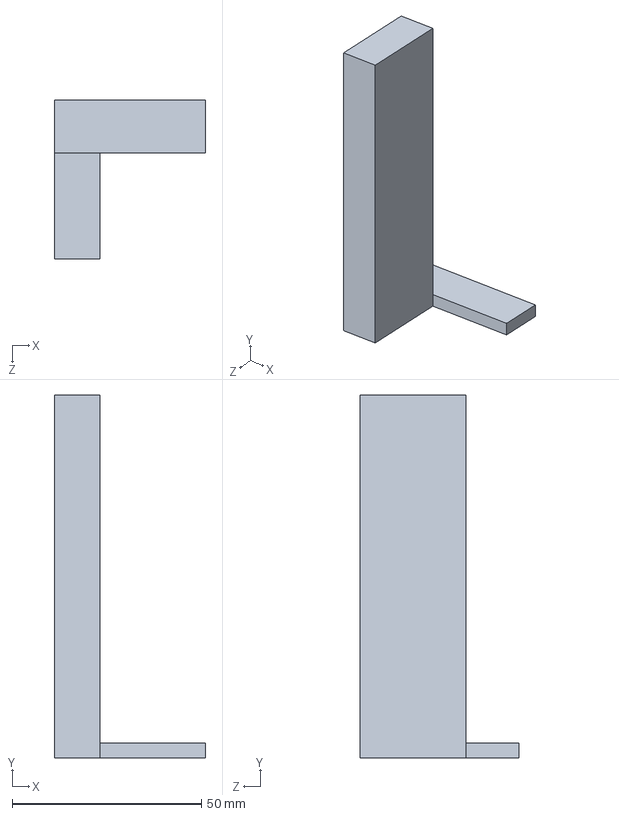
[picture p61: CAD file, 2026-11-14]
ev/cad/EV_Actuator_Bracket.SLDPRT
40.0 x 96.0 x 42.0 mm
