aryanjaykadu/F1-sma-brake-duct/ev/cfd/EV_Front_Closed.SLDPRT

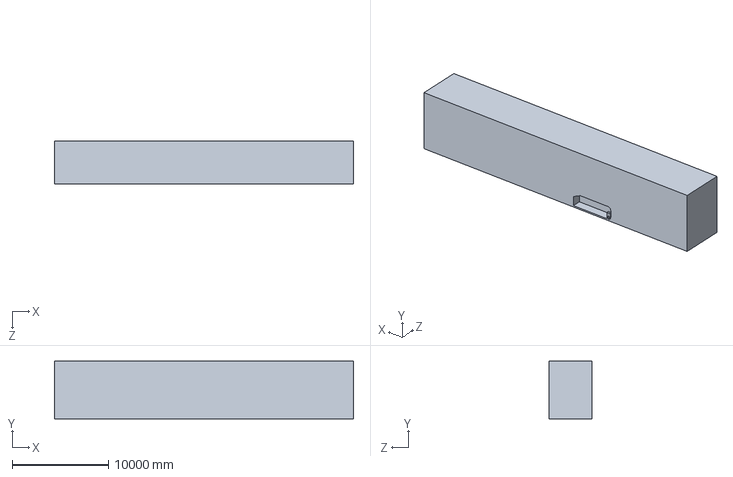
[picture p62: CAD file, 2026-11-14]
ev/cfd/EV_Front_Closed.SLDPRT
31000.0 x 6000.0 x 4500.0 mm
