aryanjaykadu/F1-sma-brake-duct/cad/Control_Linkage_Rod.STEP

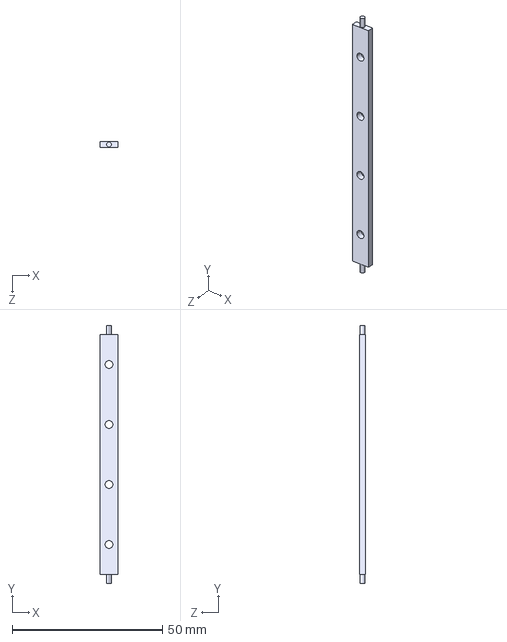
[picture p63: CAD file, 2026-11-11]
cad/Control_Linkage_Rod.STEP
6.00 x 86.0 x 2.00 mm
