aryanjaykadu/F1-sma-brake-duct/cad/product/Bias_Spring_Steel.SLDPRT

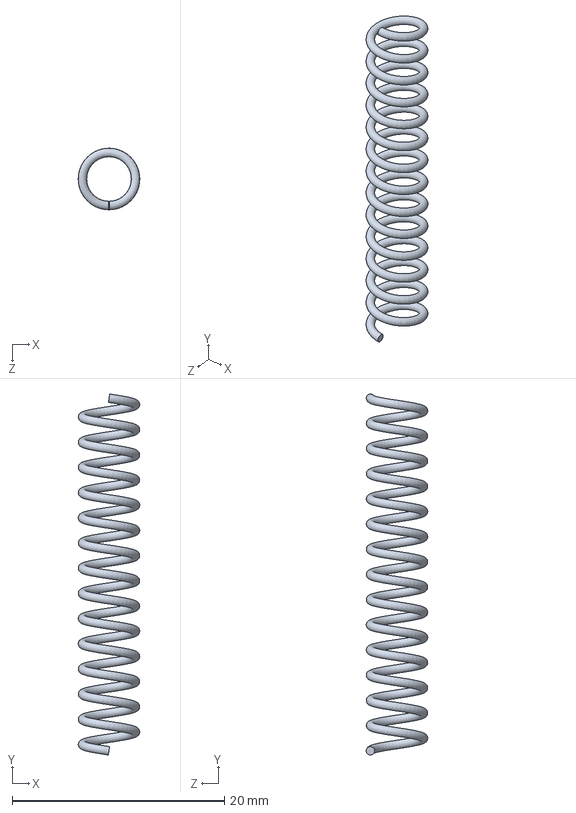
[picture p64: CAD file, 2026-11-13]
cad/product/Bias_Spring_Steel.SLDPRT
5.80 x 34.0 x 5.80 mm
