aryanjaykadu/F1-sma-brake-duct/ev/cad/EV_SMA_Spring_open.SLDPRT

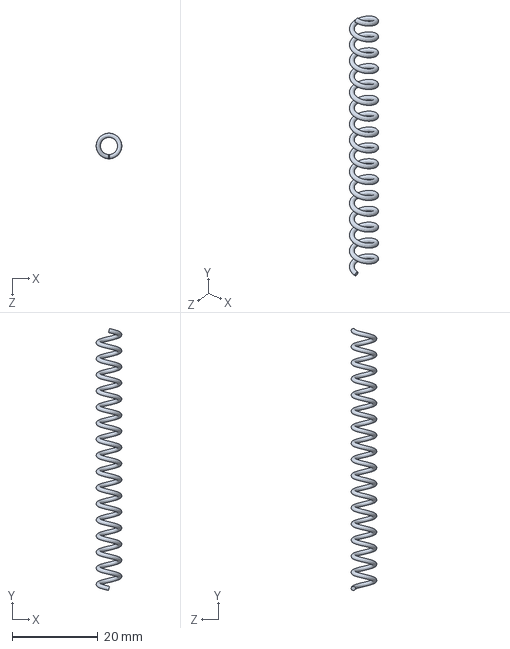
[picture p65: CAD file, 2026-11-14]
ev/cad/EV_SMA_Spring_open.SLDPRT
5.99 x 61.2 x 5.99 mm
