aryanjaykadu/F1-sma-brake-duct/cad/Nitinol_Louver_Flap.STEP

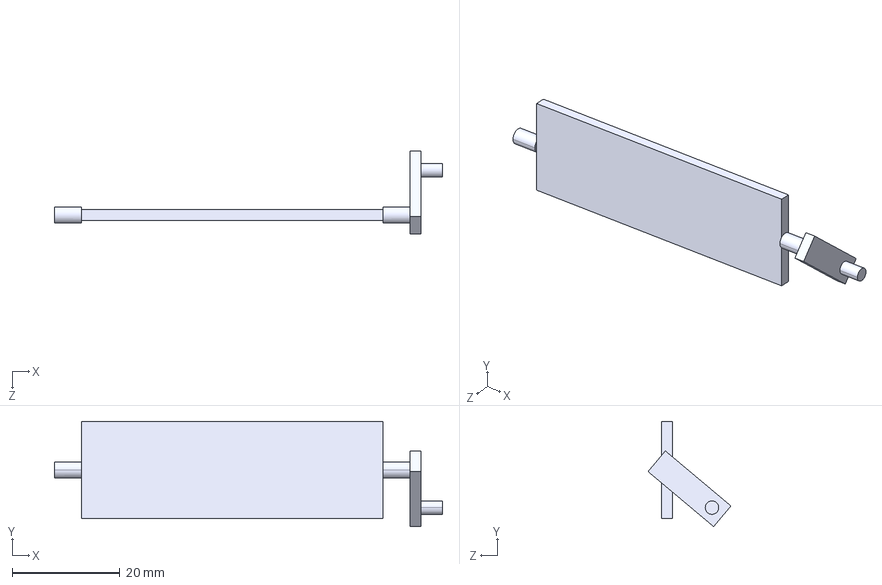
[picture p66: CAD file, 2026-11-11]
cad/Nitinol_Louver_Flap.STEP
72.0 x 19.5 x 15.4 mm
