aryanjaykadu/F1-sma-brake-duct/cad/product/Inlet_Flange.SLDPRT

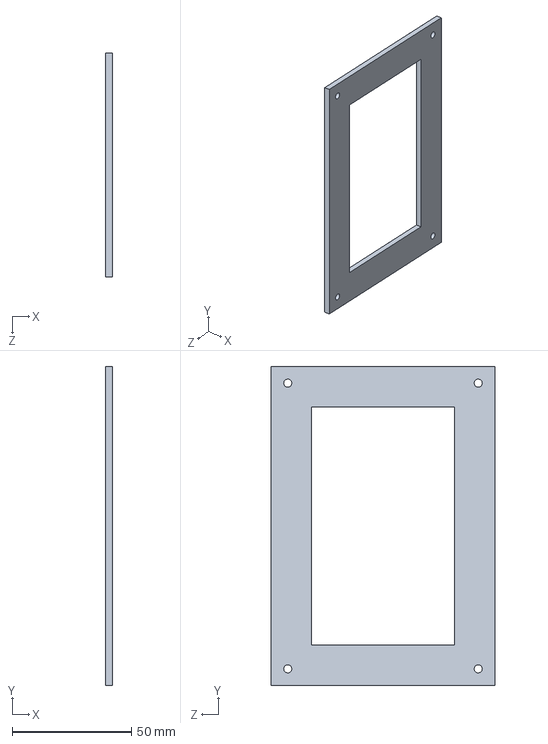
[picture p67: CAD file, 2026-11-13]
cad/product/Inlet_Flange.SLDPRT
3.00 x 134.0 x 94.0 mm
