aryanjaykadu/F1-sma-brake-duct/cad/rig/Rig_IR_Heater.STEP

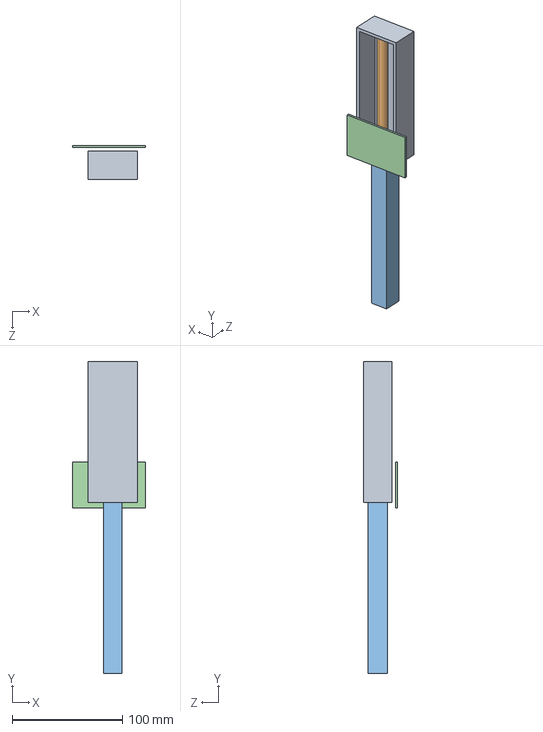
[picture p68: CAD file, 2026-11-13]
cad/rig/Rig_IR_Heater.STEP
66.0 x 283.0 x 31.0 mm
