aryanjaykadu/F1-sma-brake-duct/ev/cad/EV_SMA_Spring_closed.SLDPRT

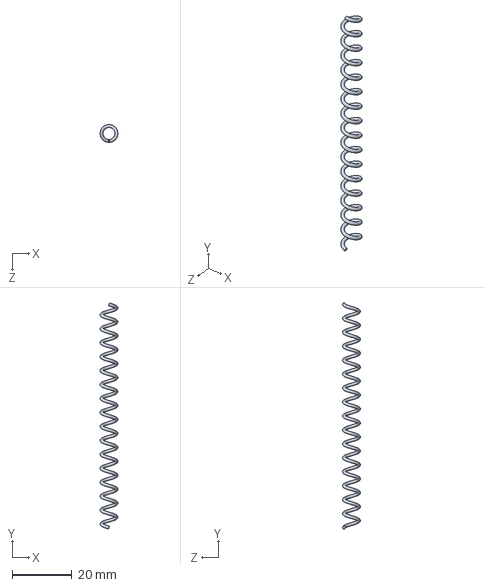
[picture p69: CAD file, 2026-11-14]
ev/cad/EV_SMA_Spring_closed.SLDPRT
5.99 x 76.0 x 5.99 mm
