aryanjaykadu/F1-sma-brake-duct/cad/Brake_Duct_Housing.STEP

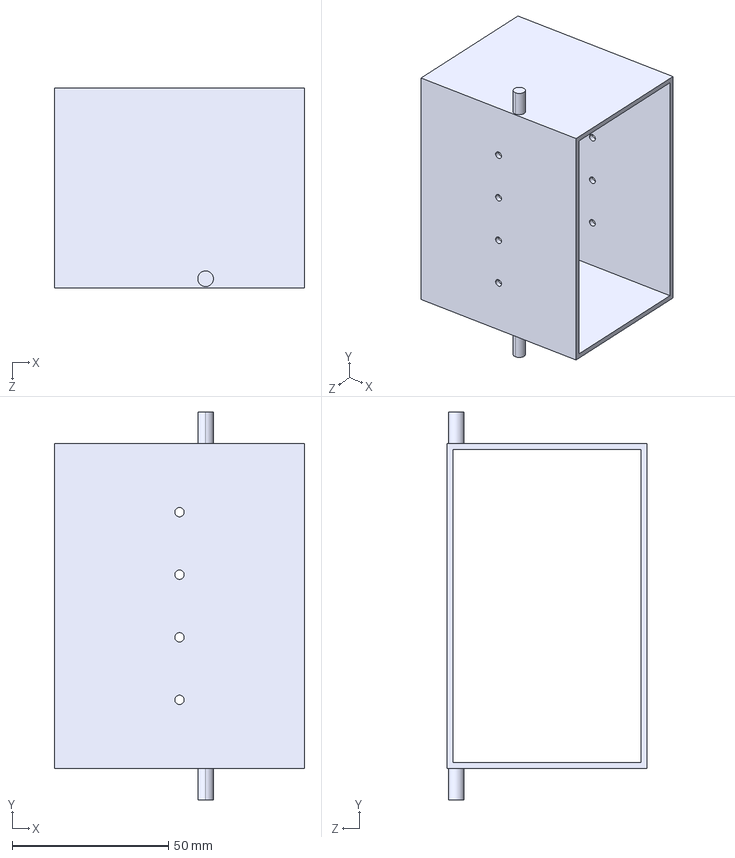
[picture p70: CAD file, 2026-11-11]
cad/Brake_Duct_Housing.STEP
80.0 x 124.0 x 64.0 mm
