aryanjaykadu/F1-sma-brake-duct/cad/product/SMA_Spring_NiTiCu_0p5.SLDPRT

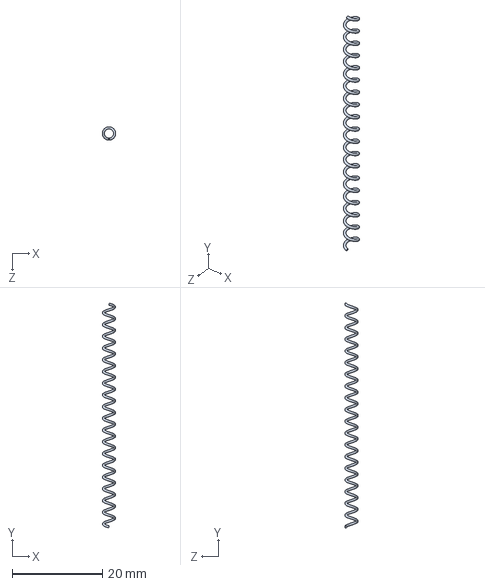
[picture p71: CAD file, 2026-11-13]
cad/product/SMA_Spring_NiTiCu_0p5.SLDPRT
3.00 x 50.0 x 3.00 mm
