aryanjaykadu/F1-sma-brake-duct/ev/cad/EV_Louver.SLDPRT

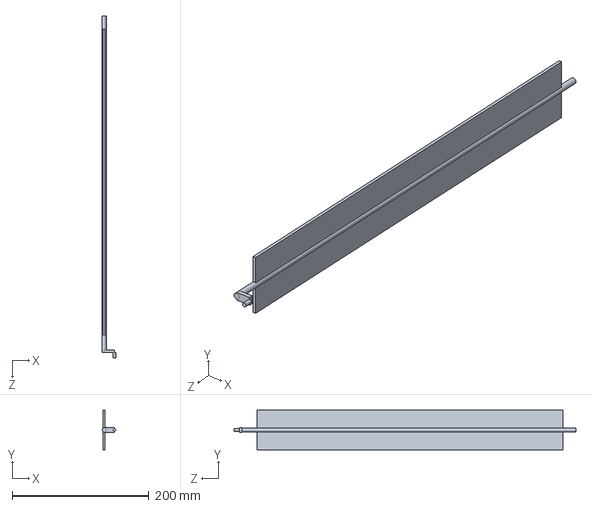
[picture p72: CAD file, 2026-11-14]
ev/cad/EV_Louver.SLDPRT
20.0 x 58.0 x 501.0 mm
