aryanjaykadu/F1-sma-brake-duct/cad/F1_Brake_Packaging_Zone.SLDPRT

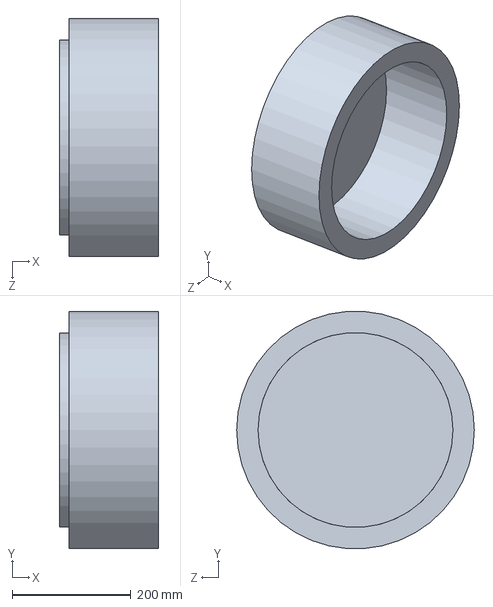
[picture p73: CAD file, 2026-11-11]
cad/F1_Brake_Packaging_Zone.SLDPRT
166.0 x 398.9 x 400.0 mm
