aryanjaykadu/F1-sma-brake-duct/cad/product/Spring_Bracket_Bottom.SLDPRT

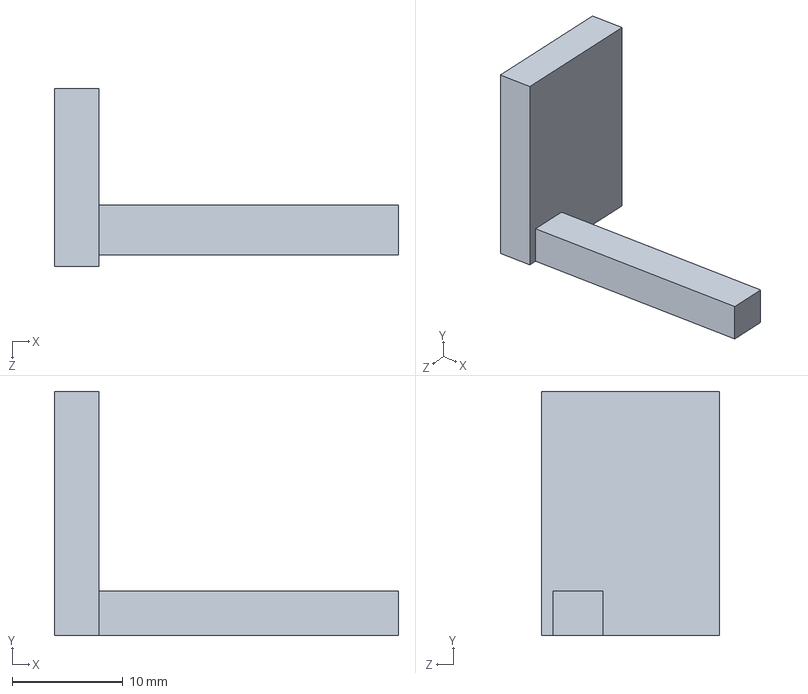
[picture p74: CAD file, 2026-11-13]
cad/product/Spring_Bracket_Bottom.SLDPRT
31.0 x 22.0 x 16.0 mm
