aryanjaykadu/F1-sma-brake-duct/cad/rig/Rig_Electronics_Box.STEP

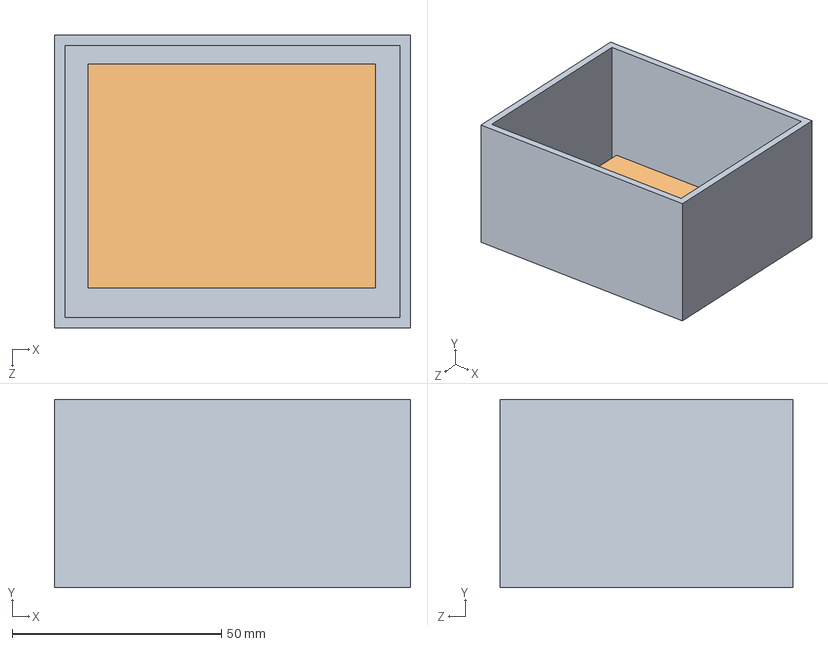
[picture p75: CAD file, 2026-11-13]
cad/rig/Rig_Electronics_Box.STEP
85.0 x 45.0 x 70.0 mm
