aryanjaykadu/F1-sma-brake-duct/ev/cad/EV_Shutter_Closed.STEP

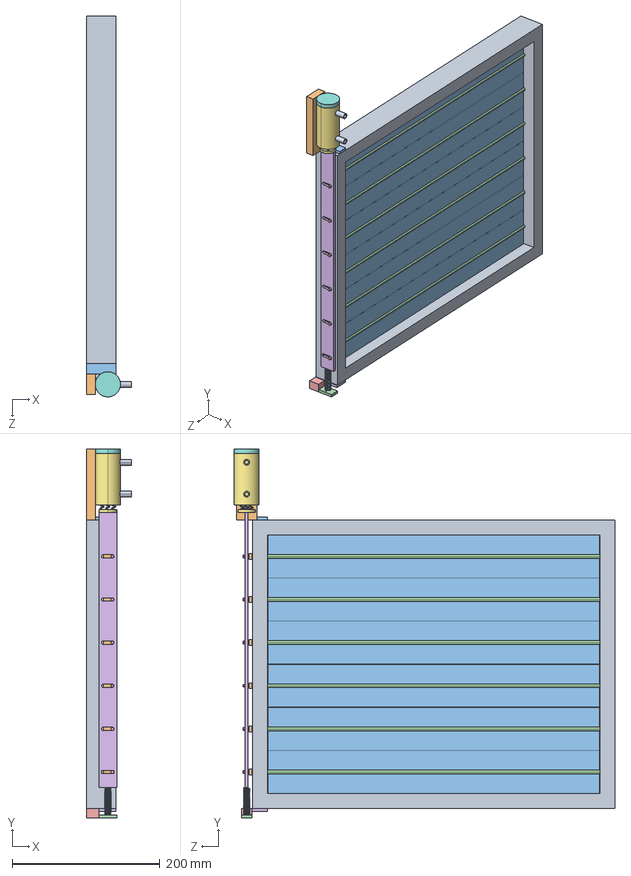
[picture p76: CAD file, 2026-11-14]
ev/cad/EV_Shutter_Closed.STEP
61.0 x 499.0 x 515.0 mm
EV_Shutter_Frame
EV_Actuator_Bracket
EV_Bias_Anchor
EV_Coolant_Sleeve
EV_Louver x 6
EV_Yoke_Bar
EV_SMA_Spring_closed x 5
EV_Bias_Spring_closed
