aryanjaykadu/F1-sma-brake-duct/cad/rig/Rig_Thermocouples.STEP

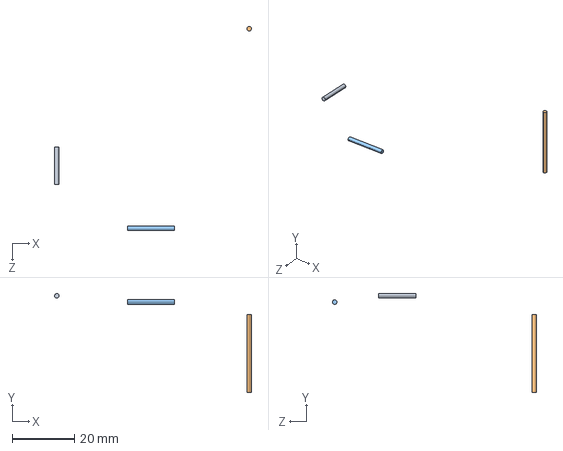
[picture p77: CAD file, 2026-11-13]
cad/rig/Rig_Thermocouples.STEP
63.2 x 31.8 x 65.5 mm
