aryanjaykadu/F1-sma-brake-duct/ev/cad/EV_Bias_Anchor.SLDPRT

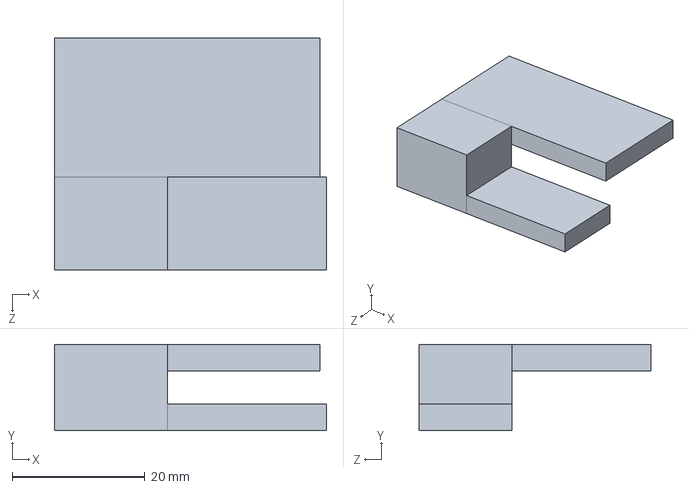
[picture p78: CAD file, 2026-11-14]
ev/cad/EV_Bias_Anchor.SLDPRT
41.0 x 13.0 x 35.0 mm
