aryanjaykadu/F1-sma-brake-duct/cad/product/SMA_Duct_Module.STEP

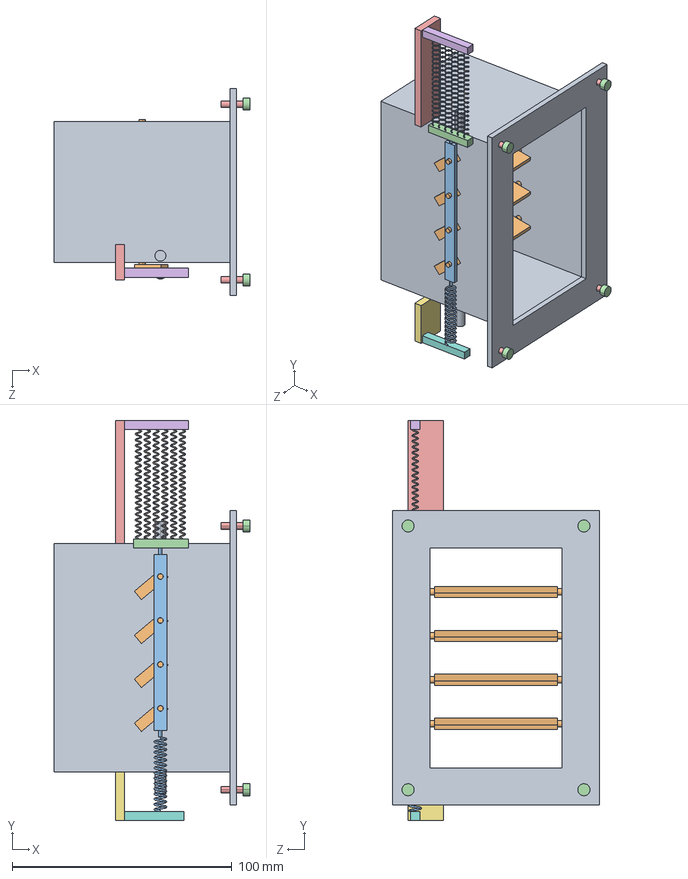
[picture p79: CAD file, 2026-11-13]
cad/product/SMA_Duct_Module.STEP
89.0 x 182.0 x 94.0 mm
Brake_Duct_Housing
Nitinol_Louver_Flap x 4
Control_Linkage_Rod
Rod_Crosshead
Spring_Bracket_Top
Spring_Bracket_Bottom
Inlet_Flange
SMA_Spring_NiTiCu_0p5 x 6
Bias_Spring_Steel
Screw_M3x10 x 4
