aryanjaykadu/F1-sma-brake-duct/cad/rig/Rig_SMA_Spring_Pack.STEP

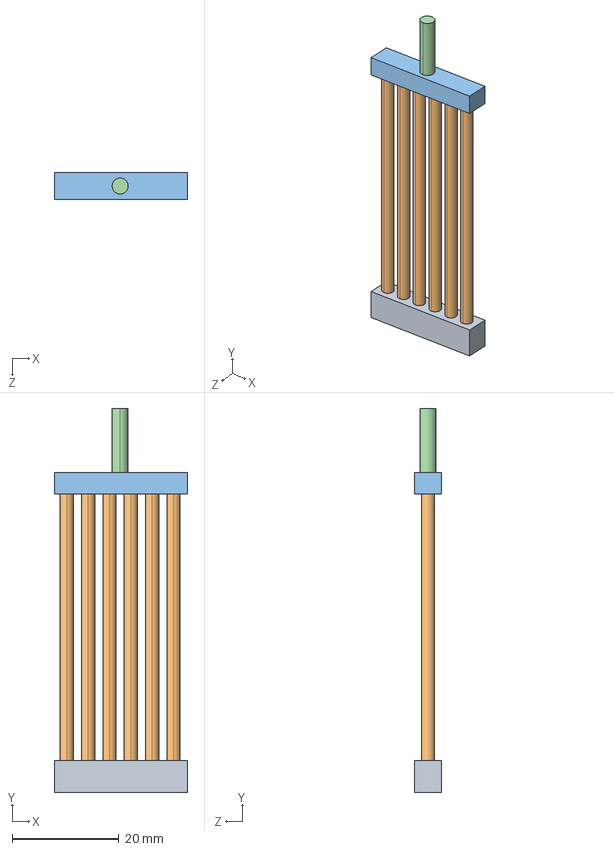
[picture p80: CAD file, 2026-11-13]
cad/rig/Rig_SMA_Spring_Pack.STEP
25.0 x 72.0 x 5.00 mm
