aryanjaykadu/F1-sma-brake-duct/ev/cad/EV_Bias_Spring_open.SLDPRT

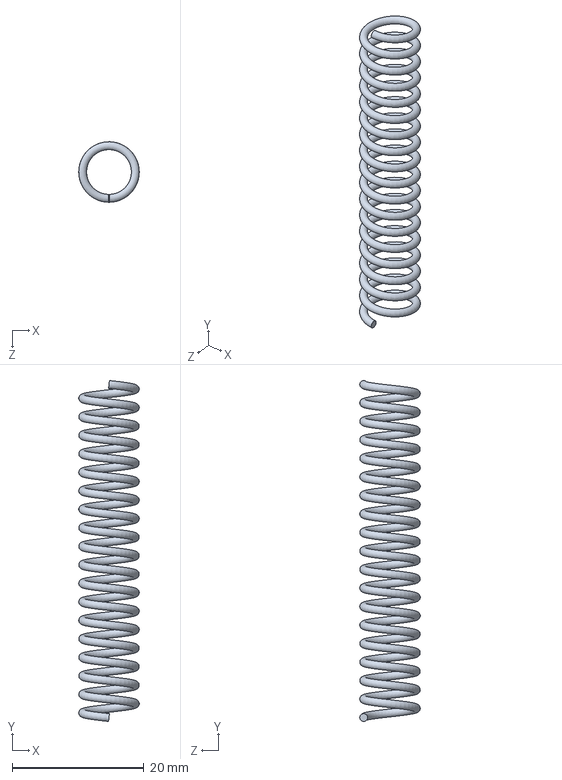
[picture p81: CAD file, 2026-11-14]
ev/cad/EV_Bias_Spring_open.SLDPRT
9.19 x 51.8 x 9.19 mm
