aryanjaykadu/F1-sma-brake-duct/cad/product/Rod_Crosshead.SLDPRT

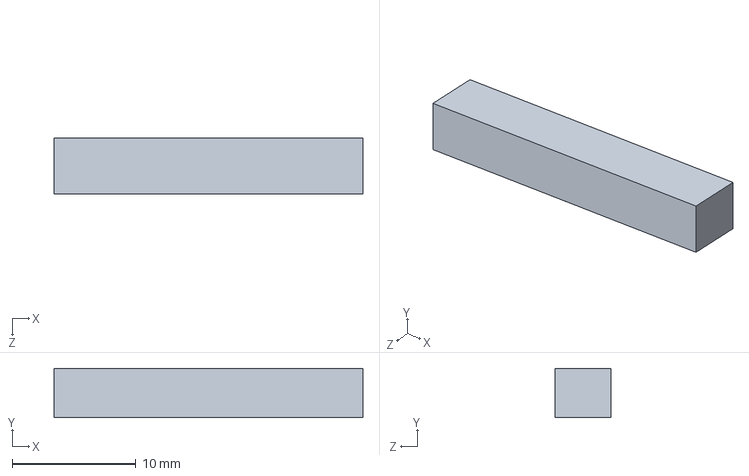
[picture p82: CAD file, 2026-11-13]
cad/product/Rod_Crosshead.SLDPRT
25.0 x 4.00 x 4.50 mm
