aryanjaykadu/F1-sma-brake-duct/ev/cad/EV_Yoke_Bar.SLDPRT

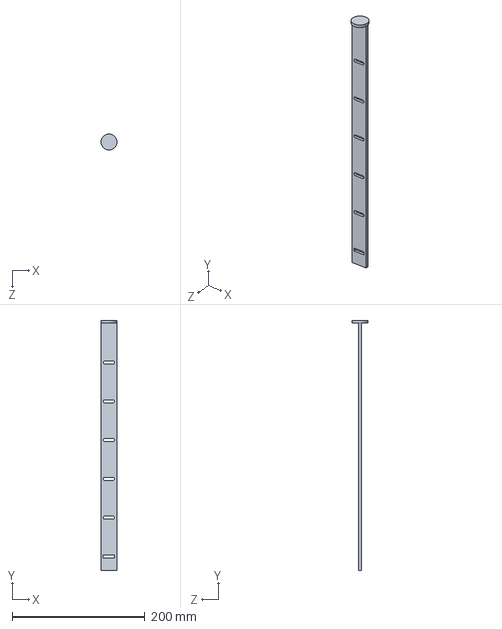
[picture p83: CAD file, 2026-11-14]
ev/cad/EV_Yoke_Bar.SLDPRT
24.0 x 376.0 x 24.0 mm
