aryanjaykadu/F1-sma-brake-duct/cad/rig/Rig_Angle_Sensor.STEP

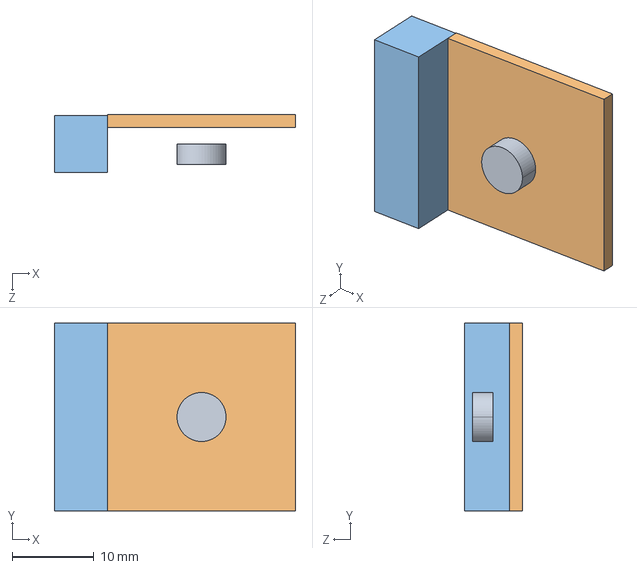
[picture p84: CAD file, 2026-11-13]
cad/rig/Rig_Angle_Sensor.STEP
29.5 x 23.0 x 7.10 mm
