aryanjaykadu/F1-sma-brake-duct/ev/cad/EV_Bias_Spring_closed.SLDPRT

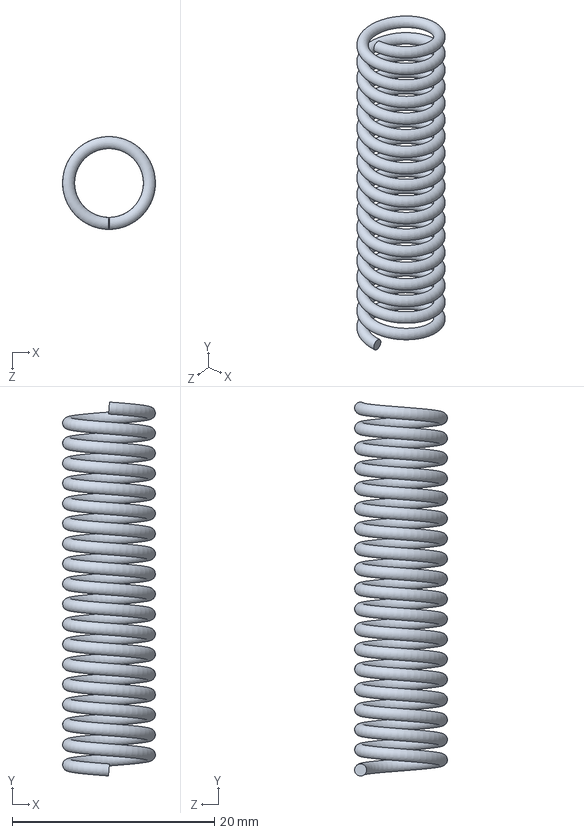
[picture p85: CAD file, 2026-11-14]
ev/cad/EV_Bias_Spring_closed.SLDPRT
9.19 x 37.0 x 9.19 mm
