aryanjaykadu/F1-sma-brake-duct/cad/rig/Rig_Fan_Plenum.STEP

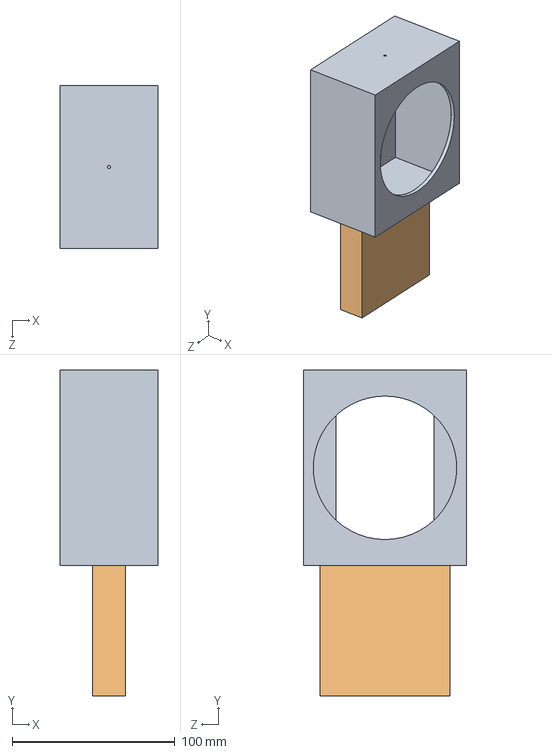
[picture p86: CAD file, 2026-11-13]
cad/rig/Rig_Fan_Plenum.STEP
60.0 x 200.0 x 100.0 mm
