aryanjaykadu/F1-sma-brake-duct/ev/cad/EV_Coolant_Sleeve.SLDPRT

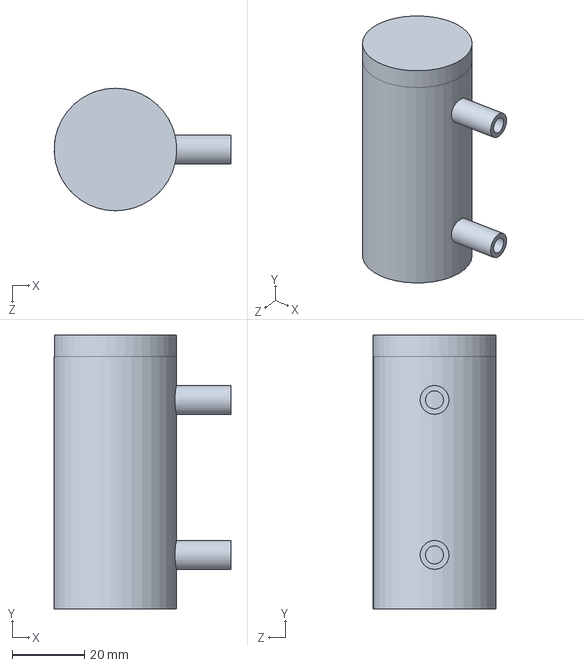
[picture p87: CAD file, 2026-11-14]
ev/cad/EV_Coolant_Sleeve.SLDPRT
49.0 x 76.0 x 34.0 mm
