aryanjaykadu/F1-sma-brake-duct/cad/rig/Bench_Rig.STEP

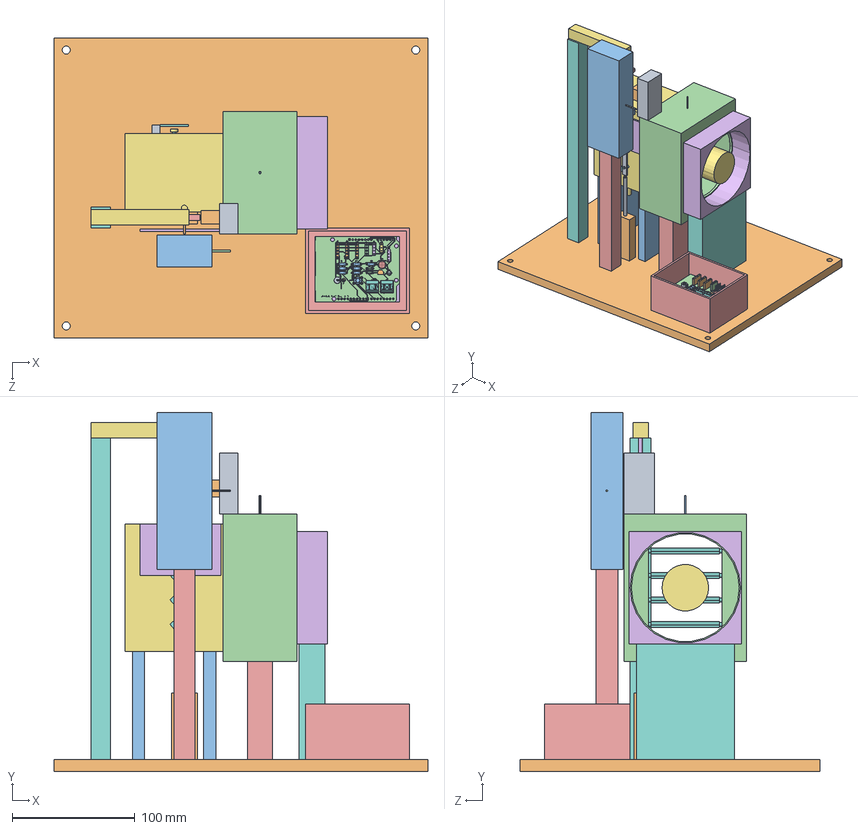
[picture p88: CAD file, 2026-11-13]
cad/rig/Bench_Rig.STEP
305.0 x 293.0 x 245.0 mm
Rig_Base_Plate
Rig_Duct_Stands
Rig_Fan_Plenum
Rig_Fan_92mm
Rig_SMA_Spring_Pack
Rig_Load_Cell
Rig_Bias_Spring
Rig_IR_Heater
Rig_Angle_Sensor
Rig_Thermocouples
Rig_Electronics_Box
Brake_Duct_Housing
Nitinol_Louver_Flap x 4
Control_Linkage_Rod
LED_D3.0mm-0.step
PinSocket_1x05_P2.54mm_Vertical-1.step x 3
R_Axial_DIN0207_L63mm_D25mm_P762mm_Horizontal.step x 7
C_Disc_D50mm_W25mm_P500mm.step x 2
CP_Radial_D63mm_P250mm.step
PinHeader_1x04_P254mm_Vertical.step x 2
PinHeader_1x03_P254mm_Vertical.step
TerminalBlock_Phoenix_MKDS-1,5-2_1x02_P5.00mm_Horizontal-2.step x 2
D_DO-201AD_P5.08mm_Vertical_AnodeUp-3.step
TO-92_Inline_Narrow.step
SW_PUSH_6mm-4.step
PinSocket_1x04_P2.54mm_Vertical-5.step
sma_rig_shield_copper.step
sma_rig_shield_pad.step
sma_rig_shield_via.step
sma_rig_shield_silkscreen.step
sma_rig_shield_PCB.step
