aryanjaykadu/F1-sma-brake-duct/ev/cad/EV_Shutter_Open.STEP

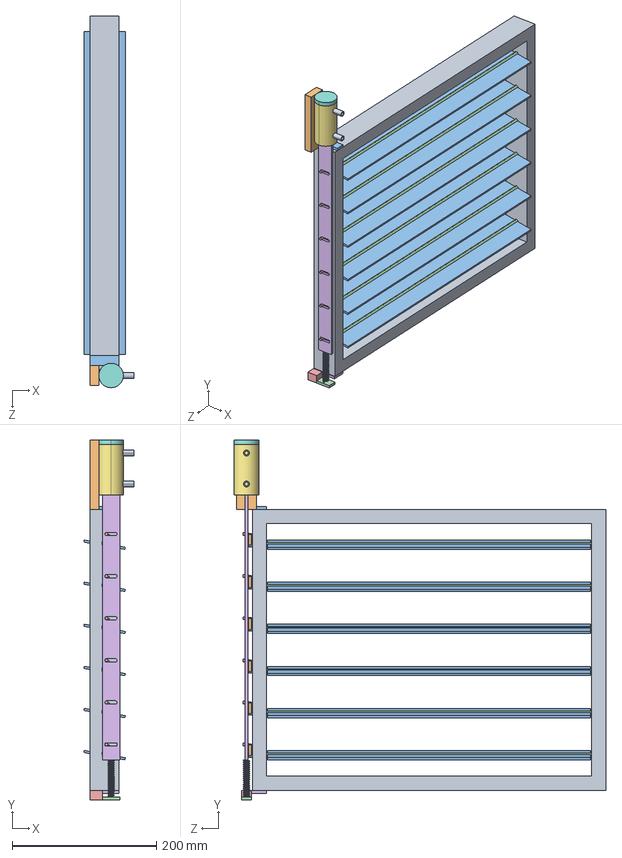
[picture p89: CAD file, 2026-11-14]
ev/cad/EV_Shutter_Open.STEP
69.8 x 499.0 x 515.0 mm
EV_Shutter_Frame
EV_Actuator_Bracket
EV_Bias_Anchor
EV_Coolant_Sleeve
EV_Louver x 6
EV_Yoke_Bar
EV_SMA_Spring_open x 5
EV_Bias_Spring_open
