aryanjaykadu/F1-sma-brake-duct/ev/cad/EV_Shutter_Frame.SLDPRT

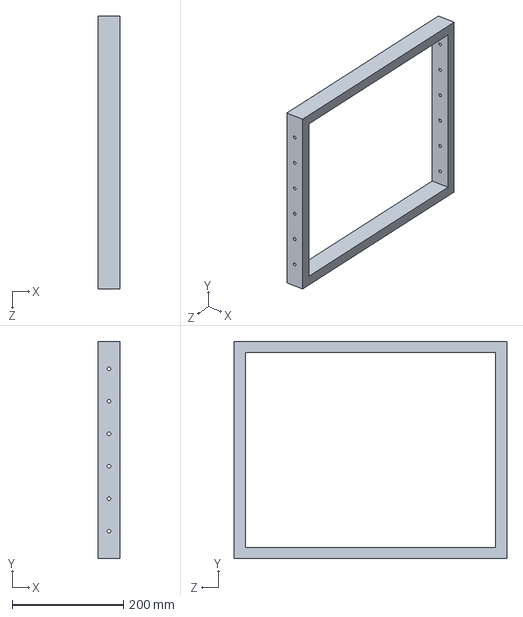
[picture p90: CAD file, 2026-11-14]
ev/cad/EV_Shutter_Frame.SLDPRT
40.0 x 390.0 x 490.0 mm
