aryanjaykadu/F1-sma-brake-duct/cad/rig/Rig_Fan_92mm.STEP

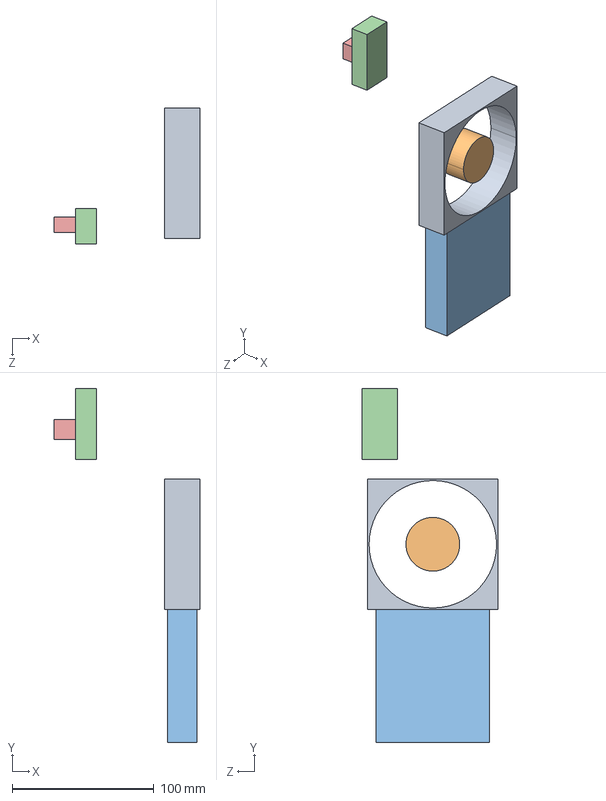
[picture p91: CAD file, 2026-11-13]
cad/rig/Rig_Fan_92mm.STEP
103.0 x 250.0 x 96.0 mm
