aryanjaykadu/F1-sma-brake-duct/cad/Phase1_ThermoKinetic_Assembly.SLDASM

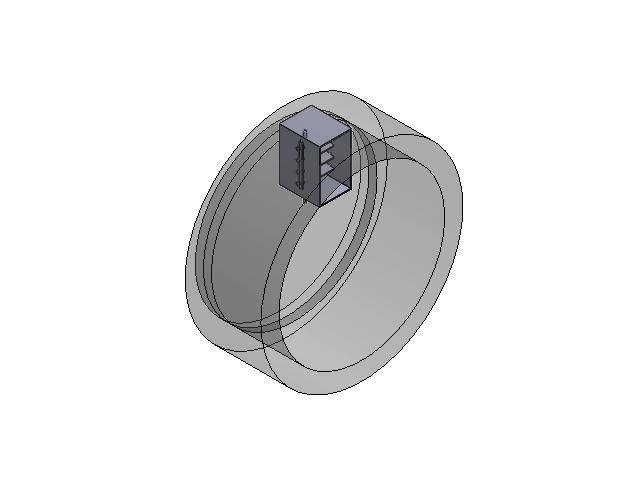
[picture p92: CAD file, 2026-11-12]
cad/Phase1_ThermoKinetic_Assembly.SLDASM
F1_Brake_Packaging_Zone
Brake_Duct_Housing
Nitinol_Louver_Flap x 4
Control_Linkage_Rod
