aryanjaykadu/F1-sma-brake-duct/(list of files, cad)

Other CAD files:
cfd/Phase2_CHT_Domain.SLDPRT
cfd/wheel/Wheel_Aero_Open.SLDPRT
ev/cfd/EV_Front_Open.SLDPRT
cad/Brake_Duct_Housing.SLDPRT
cad/Control_Linkage_Rod.SLDPRT
cad/Nitinol_Louver_Flap.SLDPRT
cad/product/SMA-DM-001.SLDDRW
cad/product/SMA_Duct_Module.SLDASM
cad/product/Screw_M3x10.SLDPRT
cad/rig/Bench_Rig.SLDASM
cad/rig/Rig_Angle_Sensor.SLDPRT
cad/rig/Rig_Base_Plate.SLDPRT
cad/rig/Rig_Bias_Spring.SLDPRT
cad/rig/Rig_Duct_Stands.SLDPRT
cad/rig/Rig_Electronics_Box.SLDPRT
cad/rig/Rig_Fan_92mm.SLDPRT
cad/rig/Rig_Fan_Plenum.SLDPRT
cad/rig/Rig_IR_Heater.SLDPRT
cad/rig/Rig_Load_Cell.SLDPRT
cad/rig/Rig_SMA_Spring_Pack.SLDPRT
cad/rig/Rig_Thermocouples.SLDPRT
cfd/Phase2_CHT_Domain.x_t
cfd/Phase2_CHT_Domain_CaseB.x_t
cfd/Phase2_CHT_Domain_baseline.x_t
cfd/wheel/Wheel_Aero_Closed.x_t
cfd/wheel/Wheel_Aero_Open.x_t
ev/cad/EV_Shutter_Closed.SLDASM
ev/cad/EV_Shutter_Open.SLDASM
ev/cfd/EV_Front_Closed.x_t
ev/cfd/EV_Front_Open.x_t
