aryanjaykadu/F1-sma-brake-duct/bench/virtual/T2_step_response.png

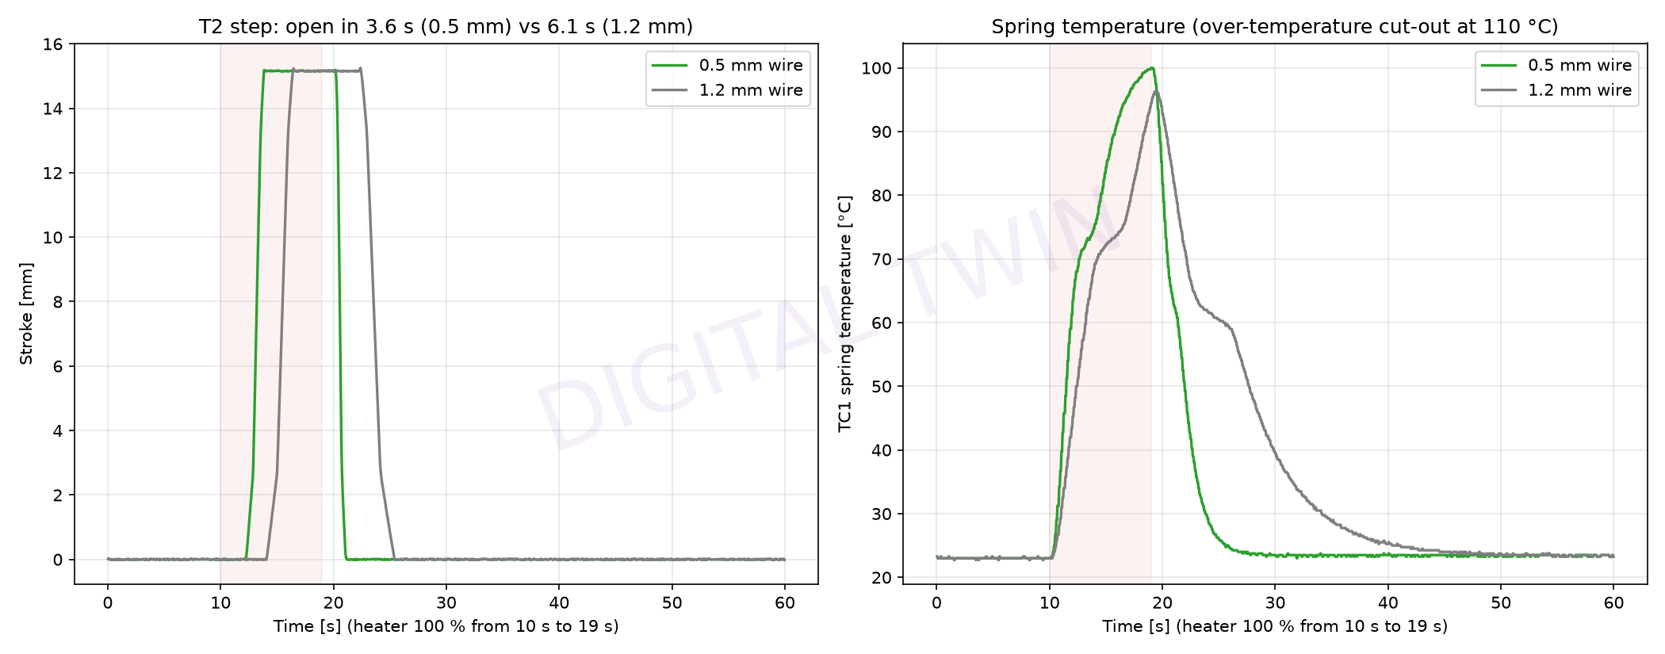
bench/virtual/T2_step_response.png
