aryanjaykadu/F1-sma-brake-duct/bench/Phase4_Bench_Test_Data.csv

sample_index | host_time_s | phase | board_timestamp_ms | temp_C | force_N | stroke_mm | fea_stroke_mm | fea_force_N | packet_age_ms | stale | source
0 | 0.0000 | heating | 132 | 25.471 | -0.117 | 0.0153 | 0.0000 | 0.000 | 1.1 | 0 | SIMULATED
1 | 0.0501 | heating | 173 | 25.834 | 0.099 | -0.0331 | 0.0000 | 0.000 | 10.5 | 0 | SIMULATED
2 | 0.1003 | heating | 214 | 25.879 | -0.185 | -0.0172 | 0.0000 | 0.000 | 19.7 | 0 | SIMULATED
3 | 0.1503 | heating | 275 | 26.429 | -0.202 | 0.0122 | 0.0000 | 0.000 | 8.8 | 0 | SIMULATED
4 | 0.2002 | heating | 316 | 26.625 | -0.504 | -0.0161 | 0.0000 | 0.000 | 17.9 | 0 | SIMULATED
5 | 0.2504 | heating | 377 | 26.801 | 0.236 | 0.0720 | 0.0000 | 0.000 | 7.2 | 0 | SIMULATED
6 | 0.3003 | heating | 417 | 26.973 | -0.153 | -0.0226 | 0.0000 | 0.000 | 16.6 | 0 | SIMULATED
7 | 0.3501 | heating | 478 | 27.187 | 0.361 | 0.0289 | 0.0000 | 0.000 | 5.6 | 0 | SIMULATED
8 | 0.4002 | heating | 519 | 27.221 | -0.280 | 0.0489 | 0.0000 | 0.000 | 14.8 | 0 | SIMULATED
9 | 0.4501 | heating | 580 | 27.679 | 0.137 | -0.0784 | 0.0000 | 0.000 | 3.5 | 0 | SIMULATED
10 | 0.5003 | heating | 620 | 27.483 | -0.158 | 0.0421 | 0.0000 | 0.000 | 13.3 | 0 | SIMULATED
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
