aryanjaykadu/F1-sma-brake-duct/electronics/kicad/sma_rig_shield_schematic.pdf

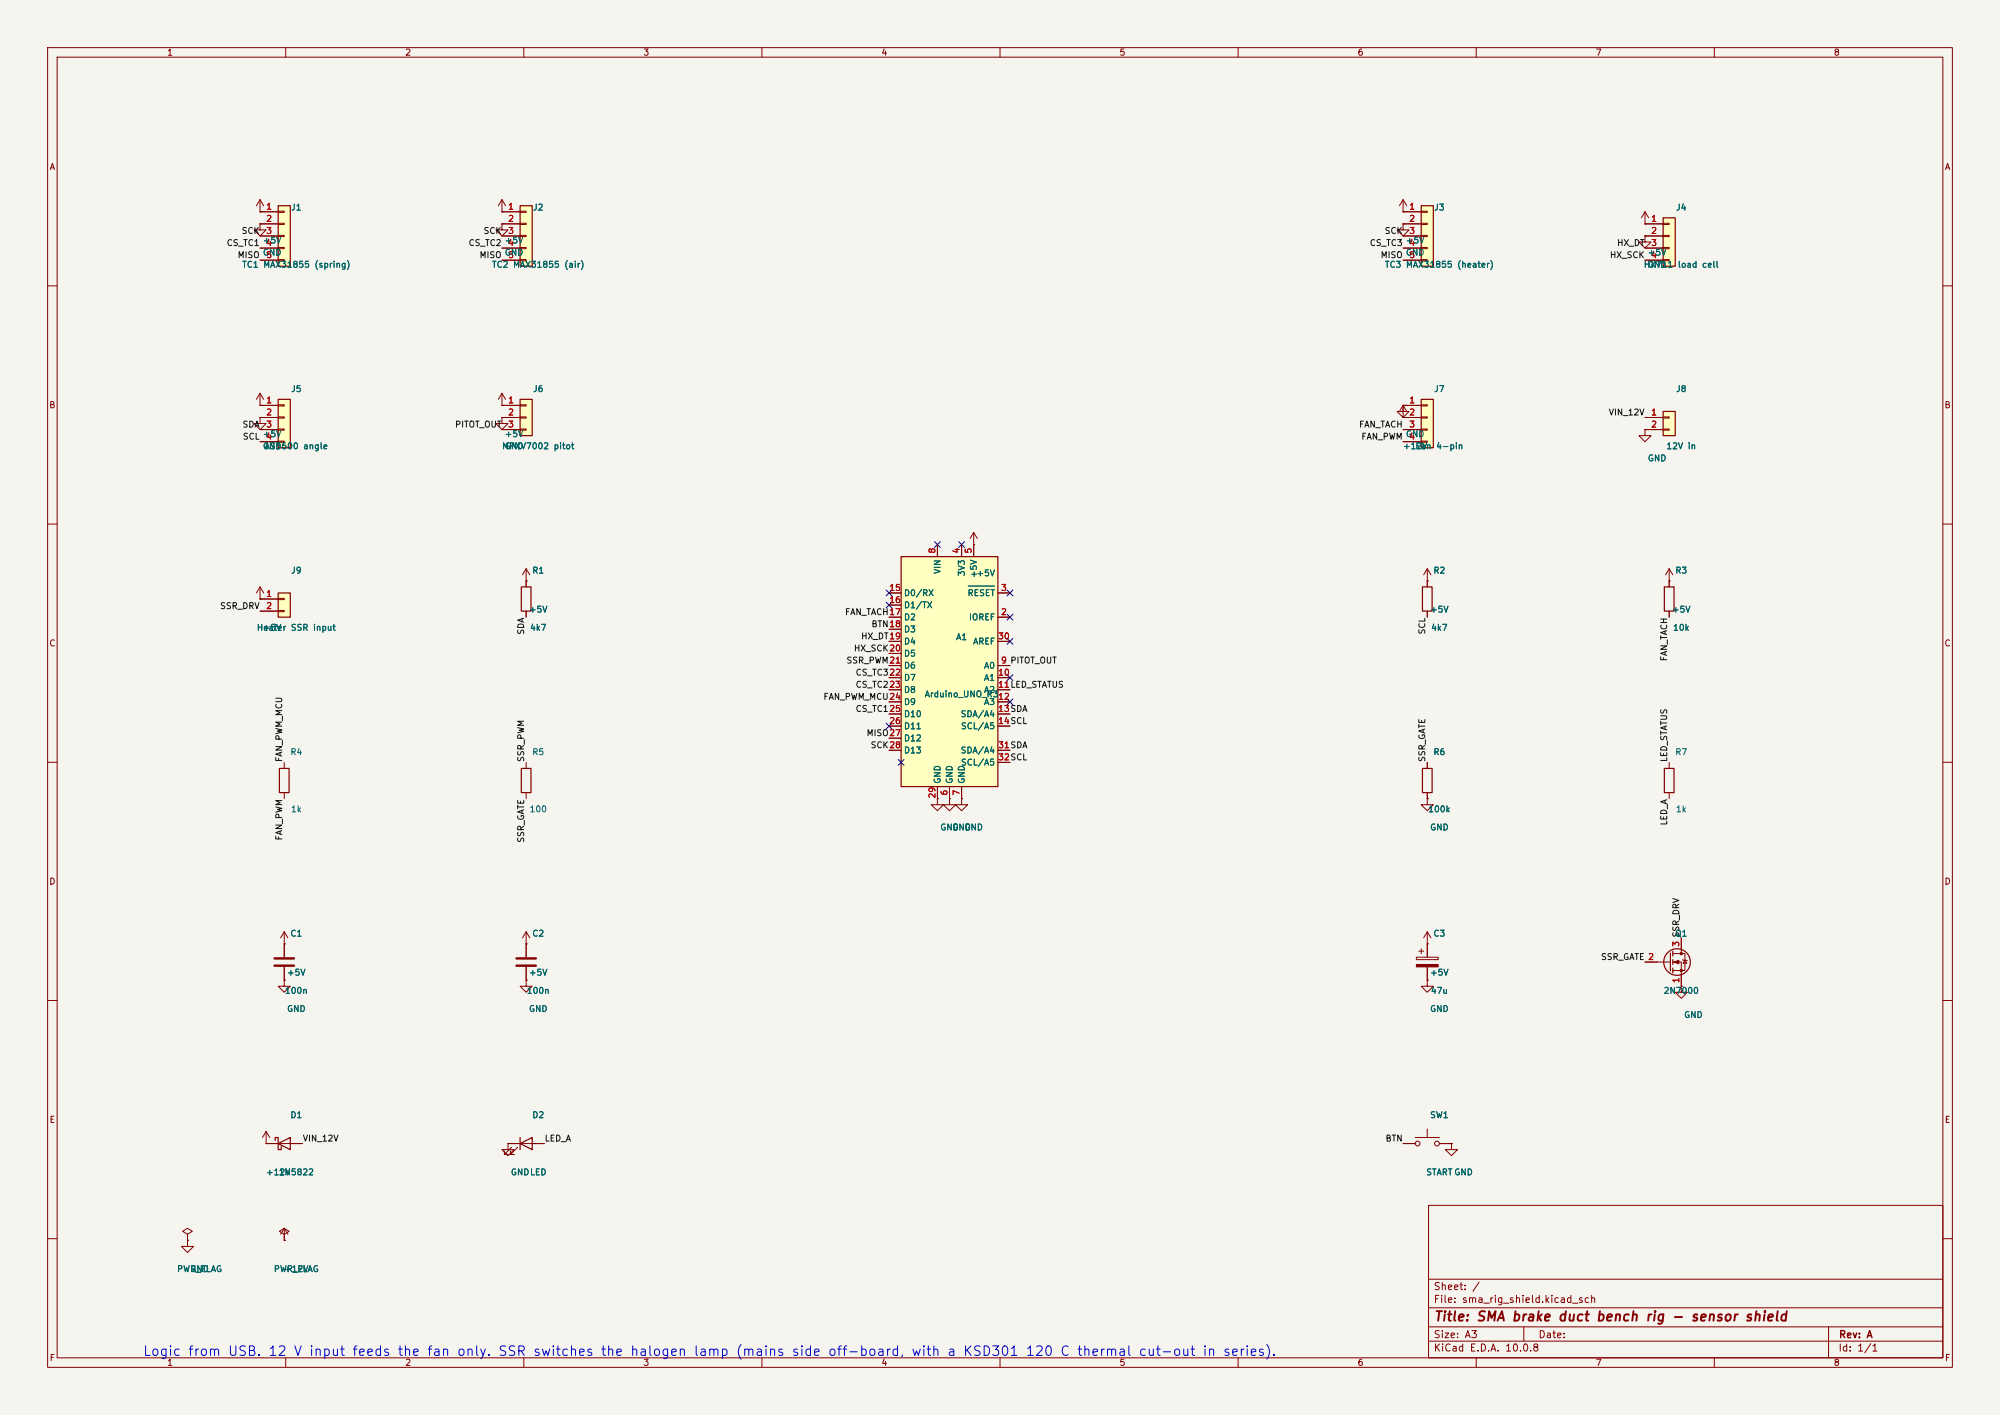
[picture p118: page 1]

Sheet: /
File: sma_rig_shield.kicad_sch
Title: SMA brake duct bench rig - sensor shield

Size: A3 | Rev: A | F Date:
KiCad E.D.A. 10.0.8 | Id: 1/1

Logic from USB. 12 V input feeds the fan only. SSR switches the halogen lamp (mains side off-board, with a KSD301 120 C thermal cut-out in series).
