aryanjaykadu/F1-sma-brake-duct/cad/product/SMA-DM-001.pdf

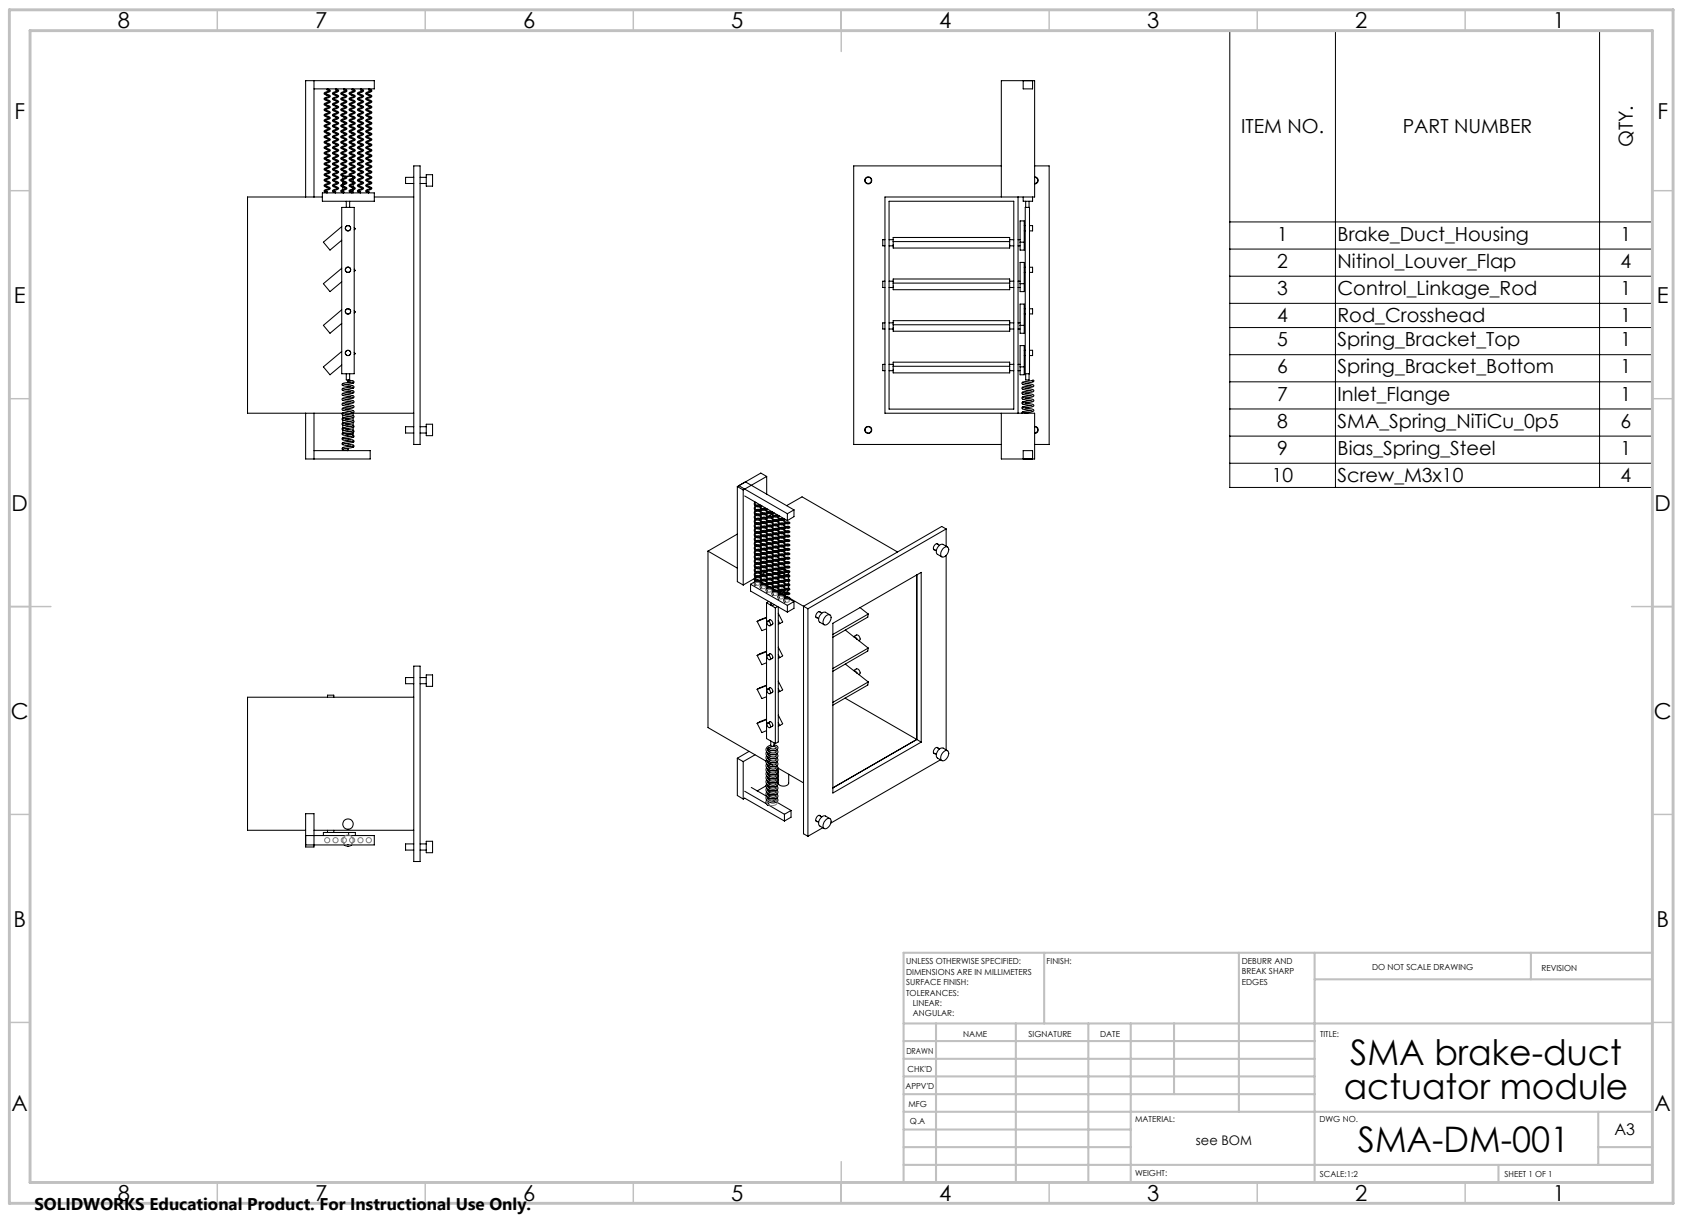
[picture p119: page 1]
FINISH:; DEBURR AND; BREAK SHARP; DO NOT SCALE DRAWING; REVISION; SCALE:1:2; SHEET 1 OF 1

ITEM NO. | PART NUMBER

1 | Brake_Duct_Housing | 1
2 | Nitinol_Louver_Flap | 4
3 | Control_Linkage_Rod | 1
4 | Rod_Crosshead | 1
5 | Spring_Bracket_Top | 1
6 | Spring_Bracket_Bottom | 1
7 | Inlet_Flange | 1
8 | SMA_Spring_NiTiCu_0p5 | 6
9 | Bias_Spring_Steel | 1
10 | Screw_M3x10 | 4

UNLESS OTHERWISE SPECIFIED:
DIMENSIONS ARE IN MILLIMETERS
SURFACE FINISH:
TOLERANCES:
LINEAR:
ANGULAR:

NAME | SIGNATURE | DATE | | | | TITLE: SMA brake-duct actuator module

DRAWN
CHK'D
APPV'D
MFG
Q.A | | | | MATERIAL: | DWG NO. SMA-DM-001 | A3 see BOM

SOLIDWORKS Educational Product. For Instructional Use Only.
