aryanjaykadu/F1-sma-brake-duct/(list of files, drawings)

Other design files:
cad/rig/pcb_import.json
