aryanjaykadu/F1-sma-brake-duct/electronics/kicad/sma_rig_shield.kicad_pcb

## KiCad design electronics/kicad/sma_rig_shield.kicad_pcb (2026-11-12)

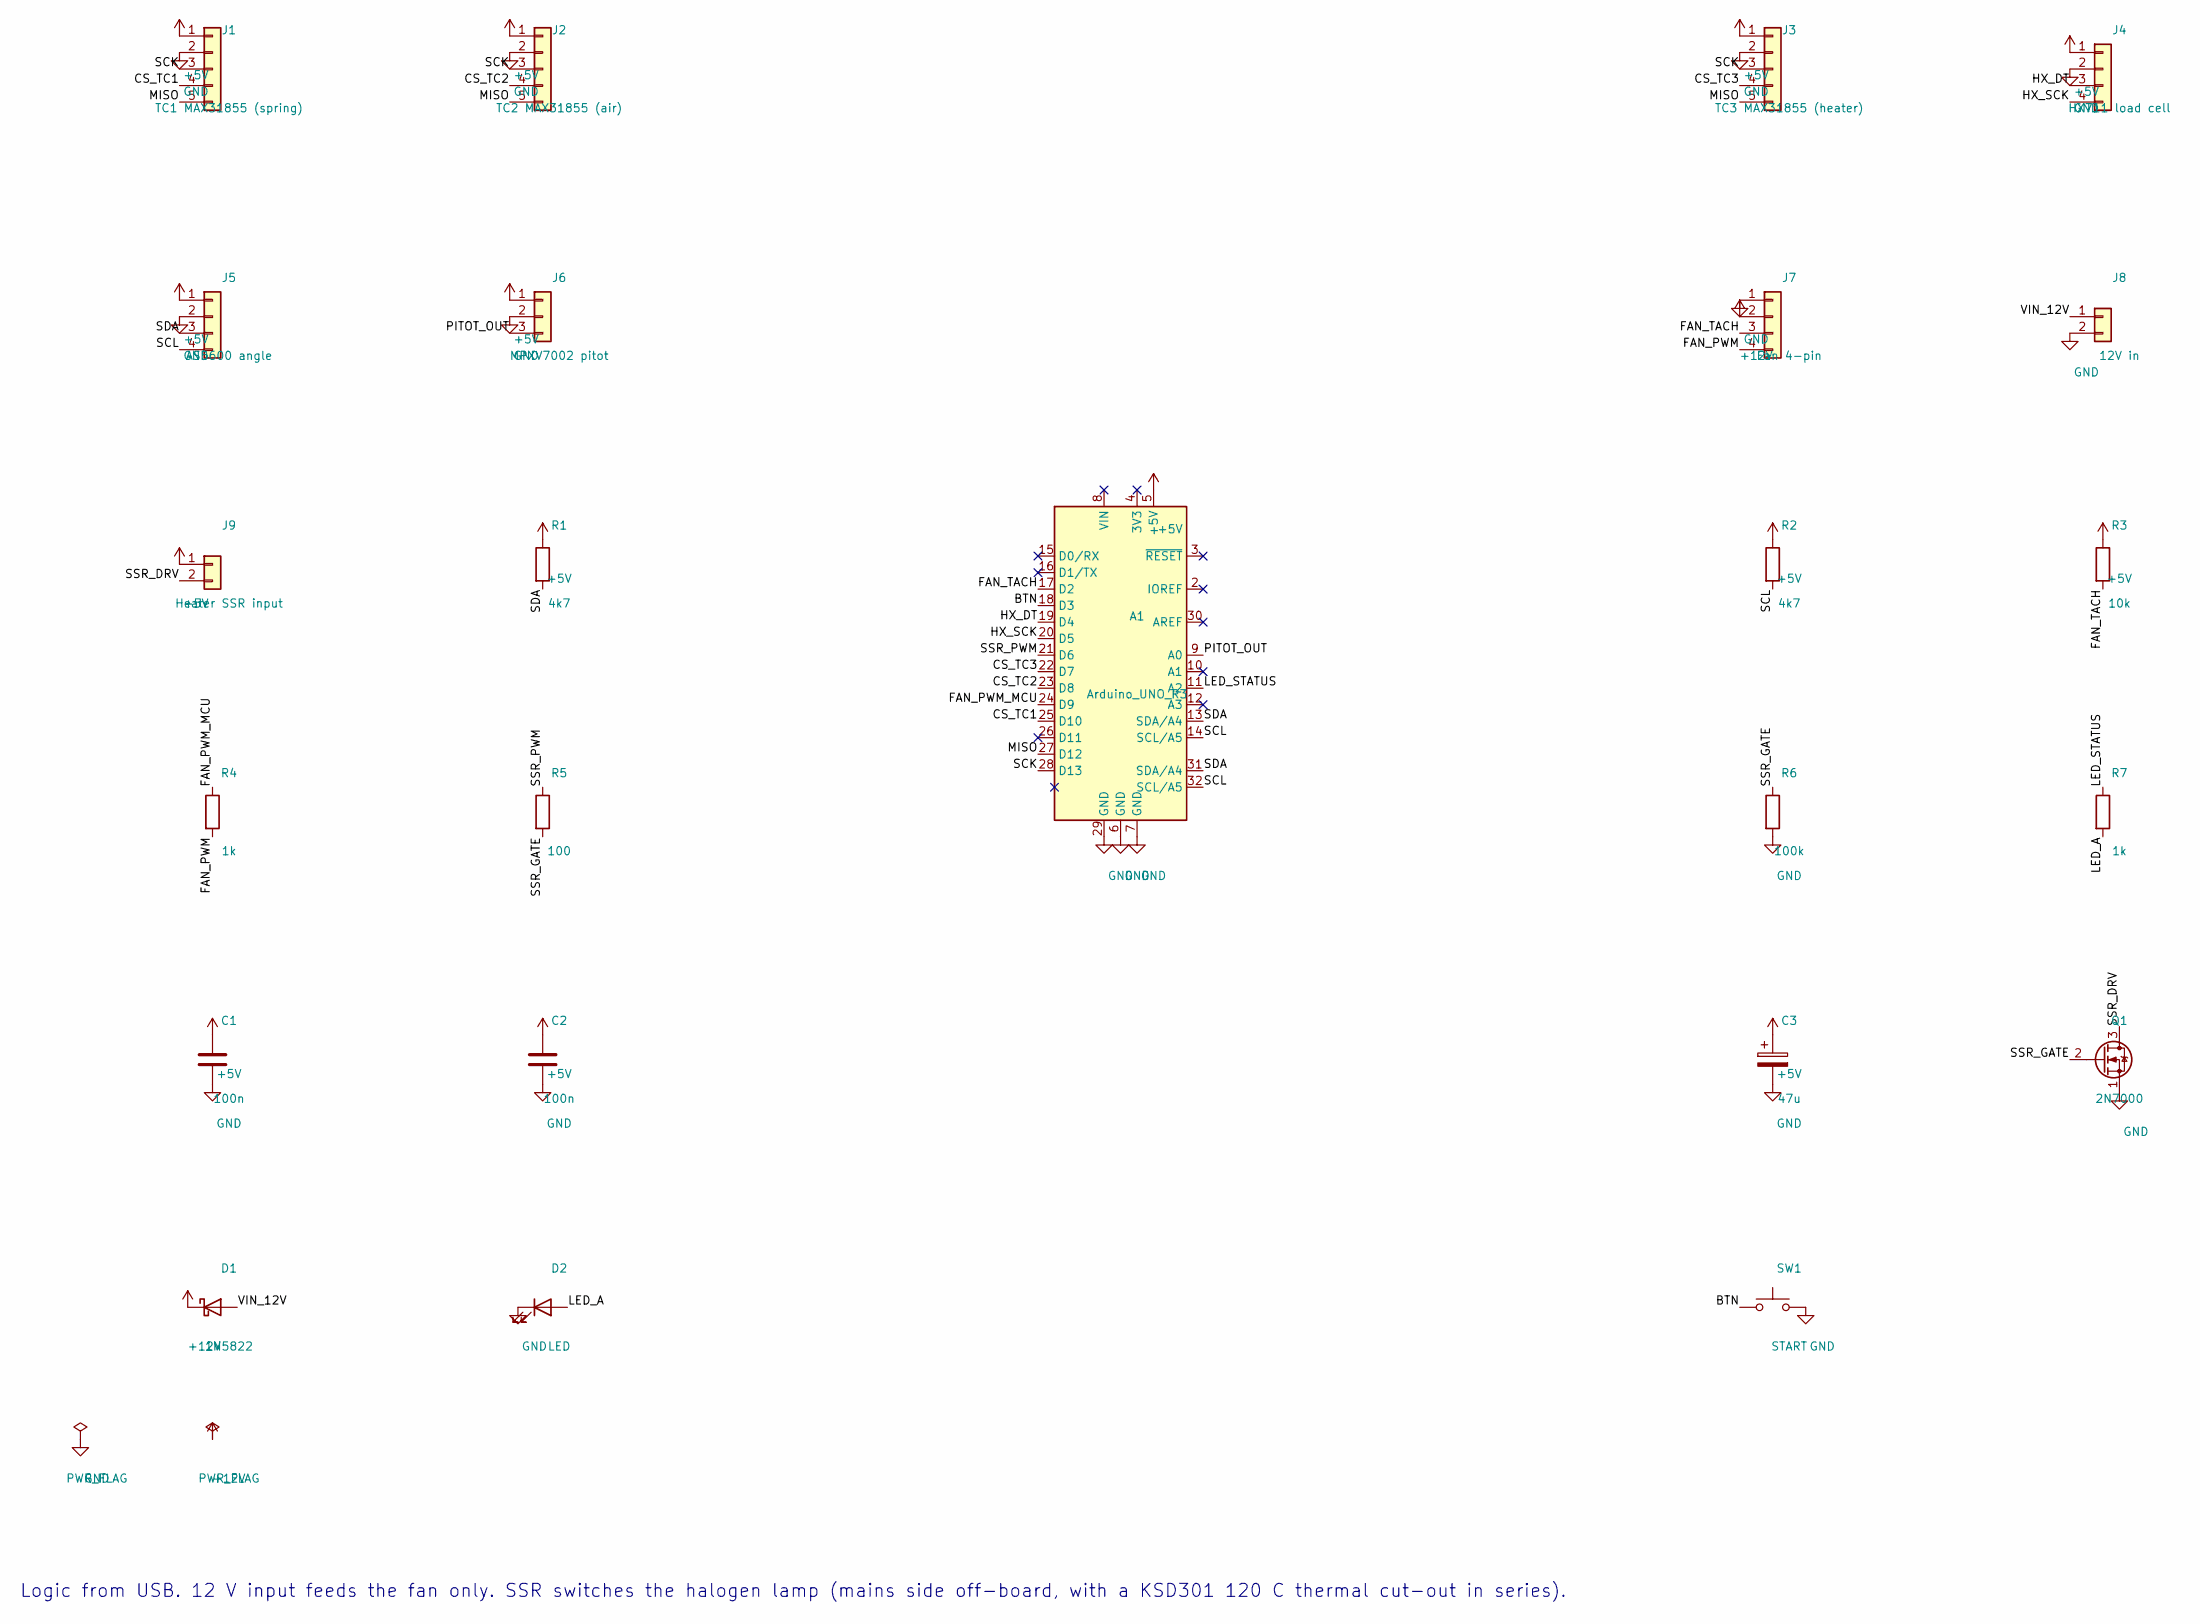
[picture p120: schematic sma_rig_shield.kicad_sch, SMA brake duct bench rig - sensor shield]

Parts:
A1: Arduino_UNO_R3; Arduino_UNO_R3_WithMountingHoles
C1, C2: 100n; C_Disc_D5.0mm_W2.5mm_P5.00mm
C3: 47u; CP_Radial_D6.3mm_P2.50mm
D1: 1N5822; D_DO-201AD_P5.08mm_Vertical_AnodeUp
D2: LED; LED_D3.0mm
J1: TC1 MAX31855 (spring); PinSocket_1x05_P2.54mm_Vertical
J2: TC2 MAX31855 (air); PinSocket_1x05_P2.54mm_Vertical
J3: TC3 MAX31855 (heater); PinSocket_1x05_P2.54mm_Vertical
J4: HX711 load cell; PinSocket_1x04_P2.54mm_Vertical
J5: AS5600 angle; PinHeader_1x04_P2.54mm_Vertical
J6: MPXV7002 pitot; PinHeader_1x03_P2.54mm_Vertical
J7: Fan 4-pin; PinHeader_1x04_P2.54mm_Vertical
J8: 12V in; TerminalBlock_Phoenix_MKDS-1,5-2_1x02_P5.00mm_Horizontal
J9: Heater SSR input; TerminalBlock_Phoenix_MKDS-1,5-2_1x02_P5.00mm_Horizontal
Q1: 2N7000; TO-92_Inline
R1, R2: 4k7; R_Axial_DIN0207_L6.3mm_D2.5mm_P7.62mm_Horizontal
R3: 10k; R_Axial_DIN0207_L6.3mm_D2.5mm_P7.62mm_Horizontal
R4, R7: 1k; R_Axial_DIN0207_L6.3mm_D2.5mm_P7.62mm_Horizontal
R5: 100; R_Axial_DIN0207_L6.3mm_D2.5mm_P7.62mm_Horizontal
R6: 100k; R_Axial_DIN0207_L6.3mm_D2.5mm_P7.62mm_Horizontal
SW1: START; SW_PUSH_6mm

Connections:
+5V: A1.5 (+5V), C1.1, C2.1, C3.1, J1.1, J2.1, J3.1, J4.1, J5.1, J6.1, J9.1, R1.1, R2.1, R3.1
+12V: D1.1 (K), J7.2
/BTN: A1.18 (D3), SW1.1
/CS_TC1: A1.25 (D10), J1.4
/CS_TC2: A1.23 (D8), J2.4
/CS_TC3: A1.22 (D7), J3.4
/FAN_PWM: J7.4, R4.2
/FAN_PWM_MCU: A1.24 (D9), R4.1
/FAN_TACH: A1.17 (D2), J7.3, R3.2
/HX_DT: A1.19 (D4), J4.3
/HX_SCK: A1.20 (D5), J4.4
/LED_A: D2.2 (A), R7.2
/LED_STATUS: A1.11 (A2), R7.1
/MISO: A1.27 (D12), J1.5, J2.5, J3.5
/PITOT_OUT: A1.9 (A0), J6.3
/SCK: A1.28 (D13), J1.3, J2.3, J3.3
/SCL: A1.14 (SCL/A5), A1.32 (SCL/A5), J5.4, R2.2
/SDA: A1.13 (SDA/A4), A1.31 (SDA/A4), J5.3, R1.2
/SSR_DRV: J9.2, Q1.3 (D)
/SSR_GATE: Q1.2 (G), R5.2, R6.1
/SSR_PWM: A1.21 (D6), R5.1
/VIN_12V: D1.2 (A), J8.1
GND: A1.6 (GND), A1.7 (GND), A1.29 (GND), C1.2, C2.2, C3.2, D2.1 (K), J1.2, J2.2, J3.2, J4.2, J5.2, J6.2, J7.1, J8.2, Q1.1 (S), R6.2, SW1.2

Notes on the sheet:
Logic from USB. 12 V input feeds the fan only. SSR switches the halogen lamp (mains side off-board, with a KSD301 120 C thermal cut-out in series).

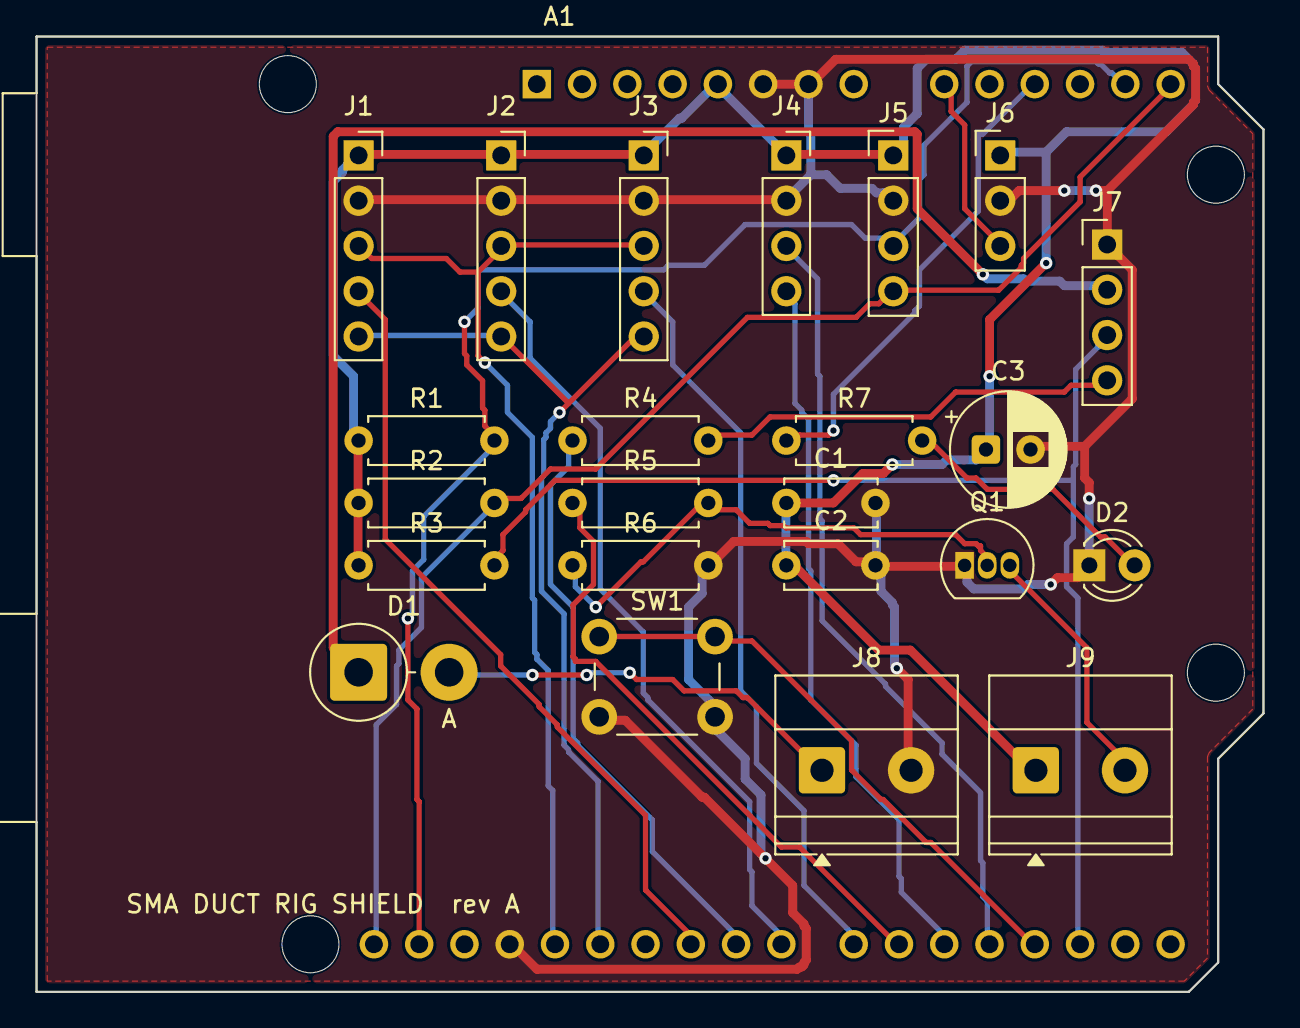
[picture p121: board sma_rig_shield.kicad_pcb from above]

Board: 2 copper layers, 68.8 x 53.6 mm, 24 parts (0 on the bottom side), 23 nets.
