aryanjaykadu/F1-sma-brake-duct/(commit log)

2026-11-11 Passive SMA brake duct feasibility study
    SOLIDWORKS CAD, ANSYS Fluent CHT and isolated-wheel aero, ANSYS MAPDL
    structure, reduced-order lap model, and the whitepaper generator.
    [Brake_Duct_Housing.SLDPRT, Brake_Duct_Housing.STEP, Control_Linkage_Rod.SLDPRT, Control_Linkage_Rod.STEP, F1_Brake_Packaging_Zone.SLDPRT, Nitinol_Louver_Flap.SLDPRT, Nitinol_Louver_Flap.STEP, Phase1_ThermoKinetic_Assembly.SLDASM]
2026-11-12 Add bench rig design, shield PCB, firmware and digital twin
    - SOLIDWORKS bench rig (lamp, blower, load cell, angle sensor), 0 interferences
    - KiCad 10 Arduino shield: ERC/DRC clean, Gerbers and BOM
    - Arduino firmware with HOLD/RAMP/LAP modes and safety cut-outs
    - Digital twin running the same firmware core, virtual test campaign
    - Fix Phase 1 rod placement (rod now on the crank pins, stroke unchanged)
    - Return-point memory in the lap-model hysteresis (results unchanged)
    [Bench_Rig.SLDASM, Bench_Rig.STEP, Logger_Twin_Run.csv, Phase1_ThermoKinetic_Assembly.SLDASM, Rig_Angle_Sensor.SLDPRT, Rig_Angle_Sensor.STEP, Rig_Base_Plate.SLDPRT, Rig_Base_Plate.STEP]
2026-11-13 Add product package for the SMA duct actuator module
    - Production-detail module CAD: helical NiTiCu and bias springs, brackets,
    inlet flange and fasteners, 0 interferences
    - Actuation animation driven by the crank kinematics and MAPDL sweep
    - A3 assembly drawing SMA-DM-001 with parts list
    - One-page product sheet
    - Bench rig now carries the KiCad 3D model of the sensor shield
    [Bench_Rig.SLDASM, Bench_Rig.STEP, Bias_Spring_Steel.SLDPRT, Inlet_Flange.SLDPRT, Rig_Angle_Sensor.SLDPRT, Rig_Angle_Sensor.STEP, Rig_Base_Plate.SLDPRT, Rig_Base_Plate.STEP]
2026-11-13 Add project guidebook and wheel-drag mesh-independence study
    - Project guidebook (PDF and Markdown): problem, working principle,
    every phase, tools, results, limits, repository map, glossary
    - Isolated-wheel drag solved on three meshes (284k, 408k, 768k cells):
    the open-vs-closed difference stays within solver noise, while the
    duct momentum limit caps any saving at 1.1-1.4 % on every mesh
    - README, results, whitepaper and product sheet now quote the limit
    [make_guidebook.py, phase2_wheel_mesh.py, phase2_wheel_mesh_compare.py, phase2_wheel_mesh_study.py, phase2_wheel_solve.py, phase5_generate_whitepaper.py, product_sheet.py]
2026-11-14 Add rotating-wheel, moving-ground drag study
    - Wheel, cover and disc rotate at 231.5 rad/s on a road moving at
    300 km/h; steady solve, then 220 ms of transient flow with drag
    time-averaged over the settled 160 ms
    - Closing the louvers adds 0.53 % drag (95 % interval +0.43 to +0.63 %):
    duct drag falls 0.4 N but wheel drag rises more
    - Guidebook, README, results, whitepaper and product sheet updated
2026-11-14 Add EV grille-shutter re-target, correct duct drag wording
    - Half-car CFD with a porous radiator and moving road: closing the
    shutters cuts drag 14.5 % at 100 and 130 km/h (105 N / 182 N)
    - Drive-cycle model now uses the CFD radiator flow coefficient and puts
    cooling drag in the road load; 3.4-5.4 % battery energy saved at a
    production-car cooling-drag level
    - SOLIDWORKS shutter module: six louvers, scotch-yoke bar, NiTi spring
    pack in a coolant sleeve, bias spring; no interferences open or shut
    - F1 docs: the 1.1-1.4 % figure is the duct's own momentum drag, not a
    cap on the total change; whitepaper, product sheet and guidebook
    regenerated
    [EV_Actuator_Bracket.SLDPRT, EV_Bias_Anchor.SLDPRT, EV_Bias_Spring_closed.SLDPRT, EV_Bias_Spring_open.SLDPRT, EV_Coolant_Sleeve.SLDPRT, EV_Front_Closed.SLDPRT, EV_Front_Closed.x_t, EV_Front_Open.SLDPRT]
